dgloeckner/remote-token-dispenser/ARCHITECTURE.md

# Token Dispenser System Architecture

This document provides a detailed architectural overview of the remote token/coin dispenser system using diagrams and flow explanations.

**📘 For complete HTTP API specification, see [dispenser-protocol.md](dispenser-protocol.md)** - detailed endpoint documentation, request/response formats, error codes, and recovery scenarios.

## Table of Contents
1. [System Overview](#system-overview)
2. [Dispense-First, Pay-After Model](#dispense-first-pay-after-model)
3. [Component Architecture](#component-architecture)
   - [Hopper Signal Configuration](#hopper-signal-configuration)
4. [API Endpoints](#api-endpoints)
5. [Transaction Flows](#transaction-flows)
6. [State Machines](#state-machines)
7. [Hardware Error Decoding](#hardware-error-decoding)
   - [Error Signal Protocol](#error-signal-protocol)
   - [Azkoyen Error Codes](#azkoyen-error-codes)
   - [Error History Tracking](#error-history-tracking)
   - [Self-Healing Behavior](#self-healing-behavior)
8. [Error Recovery](#error-recovery)
9. [Maintenance & Monitoring](#maintenance--monitoring)
   - [System Monitor Role & Responsibilities](#system-monitor-role--responsibilities)
   - [Recovery Protocols](#recovery-protocols)
10. [Example Usage: Point-of-Sale Terminal](#example-usage-point-of-sale-terminal)

---

## System Overview

The token dispenser system is a distributed embedded system with three main components communicating over WiFi HTTP and GPIO.

```mermaid
graph TB
    subgraph "Client Device"
        UI[Client App<br/>User Interface]
        Monitor[System Monitor<br/>Health & Watchdog]
        DB[(Stable Storage<br/>Transactions)]
    end

    subgraph "ESP8266 (Wemos D1)"
        HTTP[HTTP Server<br/>Port 80]
        FSM[State Machine<br/>Transaction Control]
        Flash[(Flash Storage<br/>Crash Recovery)]
    end

    subgraph "Azkoyen Hopper U-II"
        Motor[Stepper Motor<br/>Token Dispensing]
        Sensor[Opto Sensor<br/>Token Counter]
    end

    UI -->|WiFi HTTP<br/>Dispense API| HTTP
    Monitor -->|WiFi HTTP<br/>Health Checks| HTTP
    UI <-->|Read/Write| DB
    Monitor -->|Read Only| DB

    HTTP <--> FSM
    FSM <-->|Read/Write| Flash
    FSM -->|GPIO Control| Motor
    Sensor -->|GPIO Interrupt| FSM

    style UI fill:#e1f5ff
    style Monitor fill:#e1f5ff
    style DB fill:#fff3e0
    style HTTP fill:#f3e5f5
    style FSM fill:#f3e5f5
    style Flash fill:#fff3e0
    style Motor fill:#e8f5e9
    style Sensor fill:#e8f5e9
```

### Key Design Principles

1. **Dispense First, Pay After** - Payment only created if tokens successfully dispensed.
2. **Idempotency by Transaction ID** - Every request carries a `tx_id`. Retries are safe.
3. **Single Resource Locking** - Only one transaction can be active at a time on ESP8266.
4. **Crash-Safe Persistence** - Both client and ESP8266 persist state to survive power loss.
5. **Local-First Architecture** - Client stable storage is the source of truth.

---

## Dispense-First, Pay-After Model

### Core Concept

This architecture follows a **dispense-first, pay-after** model: physical tokens are dispensed from the hardware **before** any payment transaction is created or account is debited. The payment only happens after successful dispensing is confirmed.

```mermaid
graph TB
    subgraph "Traditional POS Flow"
        T1[1. Charge User]
        T2[2. Attempt Dispense]
        T3{Success?}
        T4[3. Refund if Failed]
        T5[Complete]

        T1 --> T2
        T2 --> T3
        T3 -->|Failed| T4
        T3 -->|Success| T5
        T4 --> T5

        style T1 fill:#ffebee
        style T4 fill:#ffebee
    end

    subgraph "Dispense-First Flow"
        D1[1. Dispense Tokens]
        D2[2. Verify Count]
        D3{Success?}
        D4[3. Charge User<br/>only if OK]
        D5[Complete]
        D6[No Charge]

        D1 --> D2
        D2 --> D3
        D3 -->|Success| D4
        D3 -->|Failed| D6
        D4 --> D5
        D6 --> D5

        style D4 fill:#e8f5e9
        style D6 fill:#fff3e0
    end
```

### Why This Matters

**1. Customer Protection**
- Customer is **never charged for tokens they didn't receive**
- No need for refund processes when hardware fails
- No disputes about "I paid but got nothing"

**2. Simpler Failure Handling**
- Hardware jam? Don't create payment transaction
- Partial dispense (2/3 tokens)? Charge for 2
- Complete failure? No payment record needed

**3. Eliminates Reservation Complexity**
- No need for reserve→confirm two-phase protocol
- No cancellation flow required
- No timeout management for reservations
- No "money in limbo" state

**4. Clear Audit Trail**
```
Dispense Transaction:  {tx_id, user_id, quantity, dispensed, state}
Payment Transaction:   {payment_id, dispense_tx_id, amount, timestamp}
```

Payment transaction **only exists if** dispensing succeeded. The `dispense_tx_id` link provides perfect traceability.

### Guarantees

✅ **Customer never pays without receiving tokens**
✅ **Exact token count is always recorded** (even on partial dispense)
✅ **No refunds needed** (payment only created on success)
✅ **Simple retry logic** (if dispense fails, just try again)
✅ **Clean separation** between physical operation and financial transaction

### Trade-offs

This model works well when:
- Token dispensing is the **limiting resource** (single ESP8266, one dispenser)
- Account balances are **checked before** attempting dispense
- Failed dispenses are **acceptable** (customer just retries)

This model may need adjustment if:
- Multiple dispensers must coordinate
- Regulatory requirements mandate payment-before-service
- High-value transactions require strong guarantees before dispensing

For most token-operated services (saunas, laundromats, arcades), the dispense-first model is both simpler and more customer-friendly.

---

## Component Architecture

### Client Components

```mermaid
graph LR
    subgraph "Client Device"
        subgraph "Client Application"
            AuthDevice[Auth Device<br/>RFID/NFC/Card]
            UI[User Interface<br/>Display/Touch]
            PurchaseFlow[Purchase Flow]
            DispenserClient[Dispenser Client]
        end

        subgraph "Stable Storage"
            TxTable[Transactions Store]
            UserTable[Users Store]
        end

        subgraph "System Monitor"
            HealthPoller[Health Poller<br/>60s interval]
            Watchdog[App Watchdog<br/>Process Monitor]
            SysMonitor[System Monitor<br/>Disk/Temp/Memory]
            Reporter[External Reporter<br/>healthchecks.io]
        end
    end

    AuthDevice --> PurchaseFlow
    UI --> PurchaseFlow
    PurchaseFlow --> TxTable
    PurchaseFlow --> DispenserClient

    HealthPoller -.->|HTTP GET /health| DispenserClient
    Watchdog -->|restart app| PurchaseFlow
    SysMonitor -->|query count| TxTable

    HealthPoller --> Reporter
    Watchdog --> Reporter
    SysMonitor --> Reporter

    style AuthDevice fill:#e1f5ff
    style UI fill:#e1f5ff
    style TxTable fill:#fff3e0
    style Reporter fill:#ffebee
```

### ESP8266 Components

```mermaid
graph TB
    subgraph "ESP8266 (Wemos D1)"
        subgraph "HTTP Server"
            HealthEndpoint[GET /health]
            DispenseEndpoint[POST /dispense]
            StatusEndpoint[GET /dispense/:tx_id]
        end

        subgraph "Transaction Manager"
            ActiveTx[Active Transaction<br/>In-Memory State]
            History[Ring Buffer<br/>Last 8 Transactions]
            JamWatchdog[Jam Watchdog<br/>5s Timeout Detection]
        end

        subgraph "Hardware Controller"
            MotorCtrl[Motor Controller<br/>GPIO Output]
            TokenCounter[Token Counter<br/>GPIO Interrupt]
            ErrorDecoder[Error Decoder<br/>Azkoyen Error Signals]
        end

        FlashMgr[Flash Manager<br/>EEPROM/LittleFS]
    end

    HealthEndpoint --> ActiveTx
    DispenseEndpoint --> ActiveTx
    StatusEndpoint --> History

    ActiveTx --> FlashMgr
    ActiveTx --> MotorCtrl
    TokenCounter --> ActiveTx
    ErrorDecoder --> ActiveTx

    JamWatchdog -.->|Timeout error| ActiveTx

    style HealthEndpoint fill:#f3e5f5
    style DispenseEndpoint fill:#f3e5f5
    style StatusEndpoint fill:#f3e5f5
    style FlashMgr fill:#fff3e0
    style MotorCtrl fill:#e8f5e9
    style TokenCounter fill:#e8f5e9
```

### Hopper Signal Configuration

The Azkoyen Hopper U-II uses two separate signal types that must be configured correctly:

#### 1. Motor Control Signal (Pin 7)

**Mode:** NEGATIVE (active-LOW)
**Purpose:** Control when motor runs to dispense tokens
**Configured via:** DIP switch inside hopper (⚠️ CRITICAL - must be set to NEGATIVE mode)

```mermaid
sequenceDiagram
    participant ESP8266
    participant Optocoupler as PC817 Optocoupler
    participant Motor as Hopper Motor

    Note over ESP8266: GPIO HIGH (3.3V)
    ESP8266->>Optocoupler: LED ON (13.3mA)
    Optocoupler->>Motor: OUT LOW (~0.1V)
    Note over Motor: Motor ON (dispensing)

    Note over ESP8266: GPIO LOW (0V)
    ESP8266->>Optocoupler: LED OFF
    Optocoupler->>Motor: OUT HIGH (~6V)
    Note over Motor: Motor OFF (stopped)
```

**Why NEGATIVE Mode:**
- Matches our optocoupler circuit design (GPIO HIGH → Motor ON)
- POSITIVE mode would cause inverted behavior (motor runs when it shouldn't)
- See `docs/azkoyen-hopper-protocol.md` for complete protocol specification

#### 2. Coin Detection Signal (Pin 9)

**Mode:** PULSES
**Purpose:** Count dispensed tokens
**Configured via:** Hardware jumpers (set to PULSES mode)

```mermaid
sequenceDiagram
    participant Coin
    participant Sensor as Optical Sensor
    participant ESP8266

    Note over Sensor: HIGH (idle state)
    Coin->>Sensor: Token passes through
    Note over Sensor: LOW pulse<br/>EXACTLY 30-65ms
    Sensor->>ESP8266: Interrupt triggered
    ESP8266->>ESP8266: dispensed++
    Note over Sensor: HIGH (idle state)

    Note right of ESP8266: One discrete pulse<br/>per token<br/>Independent of<br/>token speed
```

**Why PULSES Mode for Coin Counting:**

**1. Trivial Interrupt Counting**
```cpp
volatile int dispensed = 0;

void IRAM_ATTR onCoinPulse() {
    dispensed++;  // One pulse = one token
}
```
No debouncing, no edge detection complexity, no state tracking.

**2. Unambiguous Counting**
- 1 pulse = 1 token. Always. Guaranteed by hopper hardware.
- No risk of double-counting during token passage
- No timing dependencies or token speed variations

**3. Hardware-Generated Clean Signals**
- 30-65ms pulse duration is fixed and validated by hopper
- No noise or bouncing issues
- No debounce logic required in firmware

**4. Minimal CPU Overhead**
- One interrupt per token
- Simple increment operation
- No continuous signal monitoring needed

**5. Predictable Timing**
- Known pulse duration for validation/debugging
- Easy to detect jam conditions (no pulse within 5s timeout)

#### Alternative Coin Detection Modes

**NEGATIVE Mode (Active-LOW Continuous):** Signal goes LOW when token enters sensor, stays LOW while token is present, returns HIGH when token exits. Duration varies by token speed.

**POSITIVE Mode (Active-HIGH Continuous):** Signal goes HIGH when token enters sensor, stays HIGH while token is present, returns LOW when token exits. Duration varies by token speed.

**Why we don't use continuous modes for counting:**
- Require debouncing logic
- Token speed affects signal timing
- Risk of double-counting if token moves slowly
- More complex interrupt handling

These modes exist for:
- PLC integration preferring level-based signals
- Systems requiring continuous feedback during token passage
- Legacy systems with specific signal requirements

**Configuration Summary:**
- **Motor Control (Pin 7):** DIP switch set to **NEGATIVE mode** (⚠️ CRITICAL)
- **Coin Counting (Pin 9):** Jumpers set to **PULSES mode**
- See `docs/azkoyen-hopper-protocol.md` for detailed specifications

---

## API Endpoints

> **📘 Complete API Reference:** For full endpoint specifications, request/response formats, error codes, and code examples, see **[dispenser-protocol.md](dispenser-protocol.md)**.

### Authentication

**Dispense operations** (`POST /dispense`, `GET /dispense/{tx_id}`) require API key authentication:

```http
X-API-Key: your-secret-key-here
```

**Unauthorized Response (401):**
```json
{
  "error": "unauthorized"
}
```

**Health endpoint** (`GET /health`) does NOT require authentication - it's used for monitoring and diagnostics.

---

### GET /health

Returns ESP8266 health status and accumulated error metrics for monitoring.

**No authentication required** - open for monitoring systems.

> **📘 Complete API Reference:** For full response format including all fields (`wifi`, `gpio`, `error`, `error_history`), see **[dispenser-protocol.md](dispenser-protocol.md#get-health)**.

**Request:**
```http
GET /health HTTP/1.1
Host: 192.168.x.20
```

**Response Overview:**
```json
{
  "status": "ok",
  "uptime": 84230,
  "firmware": "<version>",
  "dispenser": "idle",
  "wifi": { ... },
  "gpio": { ... },
  "metrics": {
    "total_dispenses": 1247,
    "successful": 1189,
    "jams": 3,
    "partial": 2,
    "failures": 53
  },
  "error": {
    "active": false
  },
  "error_history": [ ... ]
}
```

**Key Response Fields:**
- `dispenser`: Current state (`"idle"`, `"dispensing"`, `"error"`)
- `metrics`: Cumulative statistics since boot
- `error`: Active hardware error information (if any)
- `error_history`: Last 5 error events with timestamps
- `gpio`: Real-time GPIO pin states for diagnostics
- `wifi`: Network connection information

**Purpose:**
- System Monitor polls this every 60s
- Tracks reliability over time (success rate = successful / total_dispenses)
- Detects increasing jam rates requiring maintenance
- Reports comprehensive health to external monitoring (healthchecks.io)
- Provides hardware error diagnostics via error decoding

**Example Derived Metrics:**
- **Success rate**: `successful / total_dispenses`
- **Jam rate**: `jams / total_dispenses`
- **Recent reliability**: Track deltas between polls to detect degradation
- **Active errors**: Check `error.active` for current faults

**Status Levels:**
- `"ok"`: Operating normally, no active errors
- `"degraded"`: Hopper low warning, or elevated error rates
- `"error"`: Active jam/fault, dispenser unavailable

---

## Transaction Flows

### Primary Flow: Dispense Transaction

**Design principle: Dispense first, pay after.** The payment transaction is only created if tokens are successfully dispensed.

```mermaid
sequenceDiagram
    participant User
    participant Client as Client App
    participant DB as Stable Storage
    participant ESP8266
    participant Hopper as Azkoyen Hopper

    User->>Client: Authenticate<br/>(RFID/card/etc)
    Client->>Client: Verify user
    User->>Client: Select quantity (3 tokens)

    Note over Client: Generate tx_id: "a3f8c012"
    Client->>DB: WRITE dispense transaction<br/>(tx_id, user_id, qty=3, state=pending)
    DB-->>Client: OK

    Client->>ESP8266: POST /dispense<br/>{tx_id: "a3f8c012", quantity: 3}

    ESP8266->>ESP8266: Check if idle
    ESP8266->>ESP8266: Set state=dispensing
    ESP8266->>ESP8266: Persist to flash
    ESP8266->>Hopper: Start motor (GPIO HIGH)
    ESP8266-->>Client: 200 {state: "dispensing", dispensed: 0}

    Client->>DB: UPDATE state=dispensing

    Note over Client,ESP8266: Polling Loop
    loop Every 250ms
        Client->>ESP8266: GET /dispense/a3f8c012
        Hopper-->>ESP8266: Token drop detected (interrupt)
        ESP8266->>ESP8266: Increment dispensed counter
        ESP8266-->>Client: 200 {state: "dispensing", dispensed: 1/2/3}
        Client->>User: Update progress: ●●○
    end

    ESP8266->>ESP8266: dispensed == quantity (3)
    ESP8266->>Hopper: Stop motor (GPIO LOW)
    ESP8266->>ESP8266: Set state=done
    ESP8266->>ESP8266: Persist to flash

    Client->>ESP8266: GET /dispense/a3f8c012
    ESP8266-->>Client: 200 {state: "done", dispensed: 3}

    Client->>DB: UPDATE state=complete, dispensed=3

    Note over Client: Dispense successful!<br/>Now create payment transaction
    Client->>DB: WRITE payment transaction<br/>(dispense_tx_id, user_id, amount, deduct_from_account)

    Client->>User: Success! Take 3 tokens<br/>Account charged
```

### Conflict Handling

When a second client tries to dispense while the ESP8266 is already busy.

```mermaid
sequenceDiagram
    participant User1
    participant Client1 as Client (Terminal 1)
    participant ESP8266
    participant Client2 as Client (Terminal 2)
    participant User2

    Note over ESP8266: Active: tx_id "aaa"<br/>State: dispensing

    User1->>Client1: Dispensing in progress...

    User2->>Client2: Try to start new transaction
    Client2->>ESP8266: POST /dispense<br/>{tx_id: "bbb", quantity: 2}

    ESP8266->>ESP8266: Check if idle
    Note over ESP8266: NOT idle!<br/>tx "aaa" active

    ESP8266-->>Client2: 409 Conflict<br/>{error: "busy", active_tx_id: "aaa"}

    Client2->>User2: ⚠️ Dispenser busy<br/>Please wait...

    Note over Client2: Retry after delay
    Client2->>Client2: Wait 2s

    Note over ESP8266: tx "aaa" completes
    ESP8266->>ESP8266: State: idle

    Client2->>ESP8266: POST /dispense (retry)<br/>{tx_id: "bbb", quantity: 2}
    ESP8266-->>Client2: 200 {state: "dispensing", dispensed: 0}

    Client2->>User2: Dispensing...
```

---

## State Machines

### ESP8266 Transaction State Machine

```mermaid
stateDiagram-v2
    [*] --> idle

    idle --> dispensing: POST /dispense<br/>{tx_id, quantity}

    dispensing --> done: all tokens dispensed
    dispensing --> error: jam detected<br/>OR timeout

    done --> idle: cleanup (5min)
    error --> idle: manual reset

    note right of idle
        Dispenser available
        No active tx_id
        Returns 409 if busy
    end note

    note right of dispensing
        Motor running
        Counting tokens
        tx_id persisted to flash
    end note

    note right of done
        Success
        tx_id kept in history
        for idempotency
    end note

    note right of error
        Partial dispense
        Exact count recorded
        Manual intervention needed
    end note
```

### Client Transaction Lifecycle

```mermaid
stateDiagram-v2
    [*] --> pending

    pending --> dispensing: ESP8266 dispense started
    pending --> failed: ESP8266 busy/error

    dispensing --> complete: All tokens dispensed
    dispensing --> partial: Jam/error with count < quantity
    dispensing --> failed: Hardware error with count = 0

    complete --> paid: Payment transaction created
    partial --> paid: Partial payment/refund processed

    paid --> [*]
    failed --> [*]

    note right of pending
        Dispense transaction created
        Not yet sent to ESP8266
    end note

    note right of dispensing
        Active polling
        Progress tracking
        Motor running on ESP8266
    end note

    note right of complete
        dispensed == quantity
        Ready for payment
    end note

    note right of partial
        dispensed < quantity
        Charge for actual amount
        or issue refund
    end note

    note right of paid
        Payment transaction created
        Account debited
        Final state
    end note
```

---

## Hardware Error Decoding

The system includes real-time decoding of Azkoyen Hopper error signals transmitted via Pin 8 (error signal). The hopper uses pulse-encoded error codes to communicate hardware faults.

### Error Signal Protocol

The Azkoyen Hopper reports errors using a pulse-encoded protocol:

```mermaid
sequenceDiagram
    participant Hopper
    participant ESP8266 as ESP8266 Error Decoder

    Note over Hopper: Error condition detected<br/>(e.g., coin stuck)

    Hopper->>ESP8266: Start pulse (100ms LOW)
    Note over ESP8266: Decoder enters START_PULSE state

    Hopper->>ESP8266: Code pulse 1 (10ms LOW)
    Note over ESP8266: pulseCount = 1

    Hopper->>ESP8266: Code pulse 2 (10ms LOW)
    Note over ESP8266: pulseCount = 2

    Hopper->>ESP8266: Code pulse 3 (10ms LOW)
    Note over ESP8266: pulseCount = 3

    Note over Hopper: End of sequence (200ms timeout)

    Note over ESP8266: Decode: 3 pulses = JAM_PERMANENT<br/>Record in error history
```

**Pulse Timing:**
- **Start pulse:** 100ms ±10% (90-110ms) LOW signal
- **Code pulses:** 10ms ±20% (8-12ms) LOW signals
- **Sequence timeout:** 200ms after last pulse
- **Error code:** Number of code pulses (1-7)

### Azkoyen Error Codes

| Code | Type | Description | Typical Cause | Resolution |
|---|---|---|---|---|
| 1 | `COIN_STUCK` | Token stuck in exit sensor (>65ms) | Token jammed at exit path | Clear exit, power cycle |
| 2 | `SENSOR_OFF` | Exit sensor stuck OFF | Sensor blocked or misaligned | Clean/adjust sensor |
| 3 | `JAM_PERMANENT` | Permanent jam detected | Hopper mechanism jammed | Clear jam, power cycle |
| 4 | `MAX_SPAN` | Multiple spans exceeded max time | Motor running too long | Check hopper load |
| 5 | `MOTOR_FAULT` | Motor doesn't start | Motor or driver failure | Check 12V power |
| 6 | `SENSOR_FAULT` | Exit sensor disconnected/faulty | Sensor wiring issue | Check connections |
| 7 | `POWER_FAULT` | Power supply out of range | 12V supply voltage abnormal | Check power supply |

### Error History Tracking

The ESP8266 maintains a circular buffer of the last 5 error events:

```cpp
struct ErrorRecord {
  ErrorCode code;        // 1-7 (error type)
  uint32_t timestamp;    // Uptime when detected
  bool cleared;          // Whether error was resolved
};
```

**Error Lifecycle:**

```mermaid
stateDiagram-v2
    [*] --> Detected: Error signal decoded

    Detected --> Active: Recorded in history<br/>cleared=false

    Active --> Cleared: Successful dispense<br/>OR power cycle

    Cleared --> [*]: Updated in history<br/>cleared=true

    note right of Active
        Visible in GET /health
        error.active = true
        Prevents new dispenses
    end note

    note right of Cleared
        Kept in error_history
        error.active = false
        System operational
    end note
```

### Self-Healing Behavior

**Transient errors** (temporary hardware issues) can self-heal without manual intervention:

**Mechanism:**
1. Hopper reports error (e.g., `COIN_STUCK`)
2. Error recorded in history with `cleared: false`
3. Customer initiates new dispense transaction
4. If dispense completes successfully:
   - ESP8266 automatically clears active error
   - Error marked as `cleared: true` in history
   - Dispenser continues normal operation

**Benefits:**
- Reduces maintenance interventions for transient issues
- System automatically recovers from temporary faults
- Complete audit trail maintained in error history
- No downtime for self-clearing errors

**Example Flow:**

```mermaid
sequenceDiagram
    participant Hopper
    participant ESP8266
    participant Client

    Hopper->>ESP8266: Error signal (code 1: COIN_STUCK)
    ESP8266->>ESP8266: Record error<br/>active=true, cleared=false

    Client->>ESP8266: GET /health
    ESP8266-->>Client: {error: {active: true, code: 1}}

    Note over Client: Customer attempts dispense

    Client->>ESP8266: POST /dispense {tx_id, quantity: 3}
    ESP8266->>Hopper: Start motor
    Hopper->>ESP8266: 3 token pulses
    ESP8266->>ESP8266: Dispense complete!<br/>Clear active error

    Note over ESP8266: error.active = false<br/>error.cleared = true

    Client->>ESP8266: GET /health
    ESP8266-->>Client: {error: {active: false}, error_history: [{code: 1, cleared: true}]}

    Note over Client,ESP8266: System self-healed
```

**Non-Self-Healing Errors:**

Some errors require manual intervention:
- **Timeout jams** (detected via watchdog, not hardware signal)
- **Persistent hardware faults** that don't clear after successful dispense
- **Critical errors** that prevent motor operation

These require power cycle to reset.

### Error Monitoring

The `/health` endpoint provides comprehensive error diagnostics:

```json
{
  "error": {
    "active": true,
    "code": 3,
    "type": "JAM_PERMANENT",
    "timestamp": 82150,
    "description": "Permanent jam detected"
  },
  "error_history": [
    {
      "code": 3,
      "type": "JAM_PERMANENT",
      "timestamp": 82150,
      "cleared": false
    },
    {
      "code": 1,
      "type": "COIN_STUCK",
      "timestamp": 75400,
      "cleared": true
    }
  ]
}
```

**Use Cases:**
- **Diagnostics:** Identify specific hardware issues via error codes
- **Trend analysis:** Track error frequency and types over time
- **Maintenance planning:** High error rates indicate need for service
- **Root cause analysis:** Error history provides failure patterns

---

## Error Recovery

### Scenario 1: ESP8266 Crashes Mid-Dispense

```mermaid
sequenceDiagram
    participant Client
    participant ESP8266
    participant Flash as ESP8266 Flash
    participant Hopper

    Note over ESP8266: Dispensing tx "abc"<br/>quantity: 3<br/>dispensed: 2

    ESP8266->>Flash: Persist {tx: "abc", qty: 3, dispensed: 2}
    Flash-->>ESP8266: OK

    Note over ESP8266: 💥 POWER LOSS

    Note over ESP8266: ...reboot...

    ESP8266->>ESP8266: Boot sequence
    ESP8266->>Flash: Read persisted state
    Flash-->>ESP8266: {tx: "abc", qty: 3, dispensed: 2}

    ESP8266->>ESP8266: Recover to error state<br/>(incomplete transaction)
    Note over ESP8266: State: error<br/>tx "abc", dispensed=2

    Client->>ESP8266: GET /dispense/abc<br/>(periodic poll after timeout)

    ESP8266-->>Client: 200 {state: "error", error: "reboot",<br/>quantity: 3, dispensed: 2}

    Client->>Client: Record partial dispense
    Note over Client: Storage: state=partial<br/>dispensed=2

    Client->>Client: Show error to user
    Note over Client: "Partial dispense: 2/3 tokens.<br/>Contact staff."
```

### Scenario 2: Client Crashes Mid-Transaction

```mermaid
sequenceDiagram
    participant Client
    participant DB as Stable Storage
    participant ESP8266

    Note over Client: Dispensing tx "xyz"<br/>polling ESP8266...

    Note over Client: 💥 POWER LOSS

    Note over Client: ...reboot...
    Note over ESP8266: Still dispensing<br/>or completed

    Client->>Client: Boot sequence
    Client->>DB: READ transactions<br/>WHERE state IN ('pending', 'dispensing')

    DB-->>Client: [{tx_id: "xyz", state: "dispensing", qty: 3}]

    Client->>ESP8266: GET /dispense/xyz

    alt Transaction completed during outage
        ESP8266-->>Client: 200 {state: "done", dispensed: 3}
        Client->>DB: UPDATE state=complete, dispensed=3
        Note over Client: Recovery successful
    else Transaction still in progress
        ESP8266-->>Client: 200 {state: "dispensing", dispensed: 2}
        Client->>Client: Resume polling
        Note over Client: Continue normal flow
    else Transaction errored
        ESP8266-->>Client: 200 {state: "error", dispensed: 2}
        Client->>DB: UPDATE state=partial, dispensed=2
        Note over Client: Manual intervention
    else Transaction timed out
        ESP8266-->>Client: 404 Not Found
        Client->>DB: UPDATE state=expired
        Note over Client: Refund/retry logic
    end
```

### Scenario 3: Network Timeout During Dispense Request

```mermaid
sequenceDiagram
    participant Client
    participant Network as WiFi Network
    participant ESP8266

    Note over ESP8266: State: idle

    Client->>Network: POST /dispense<br/>{tx_id: "def", quantity: 3}

    Note over Network: 📡 Packet lost

    Note over Client: Timeout (3s)
    Note over ESP8266: Never received request!<br/>Still idle

    Client->>Client: Retry logic (attempt 2)
    Client->>ESP8266: POST /dispense<br/>{tx_id: "def", quantity: 3}<br/>[SAME tx_id]

    ESP8266->>ESP8266: Check tx_id "def"
    Note over ESP8266: Not found in history<br/>New transaction

    ESP8266->>ESP8266: Start dispensing
    ESP8266-->>Client: 200 {state: "dispensing", dispensed: 0}

    Note over Client,ESP8266: Safe retry - dispense starts on first successful delivery
```

### Scenario 4: Hopper Jam Detection

```mermaid
sequenceDiagram
    participant Client
    participant ESP8266 as ESP8266 Firmware
    participant Hopper

    Note over ESP8266: Dispensing tx "ghi"<br/>quantity: 4<br/>dispensed: 2

    ESP8266->>Hopper: Motor running (GPIO HIGH)
    ESP8266->>ESP8266: Start watchdog timer<br/>(5s per-token timeout)

    Note over Hopper: 🔧 Jam! No token drops

    Note over ESP8266: Wait 5s...<br/>No pulse received!<br/>Watchdog timeout triggered

    ESP8266->>Hopper: Stop motor (GPIO LOW)
    ESP8266->>ESP8266: Set state=error<br/>error="jam"<br/>dispensed=2
    ESP8266->>ESP8266: Persist to flash

    Client->>ESP8266: GET /dispense/ghi<br/>(polling)

    ESP8266-->>Client: 200 {state: "error", error: "jam",<br/>quantity: 4, dispensed: 2}

    Client->>Client: Update storage: state=partial, dispensed=2
    Client->>Client: Show error UI

    Note over Client: "Hardware error: 2/4 tokens dispensed.<br/>Contact staff to clear jam."
```

---

## Example Usage: Point-of-Sale Terminal

### Example Physical Layout

```mermaid
graph TB
    subgraph "Counter Top"
        Terminal[POS Terminal<br/>Client Device<br/>Display + Auth Device]
    end

    subgraph "Behind/Below Counter"
        Dispenser[Enclosure<br/>ESP8266 + Azkoyen Hopper]
    end

    subgraph "Network Infrastructure"
        WiFi[WiFi Router<br/>Local Network<br/>192.168.x.x]
        Internet[Internet<br/>External Monitoring]
    end

    Terminal -->|WiFi| WiFi
    Dispenser -->|WiFi| WiFi
    Terminal -->|Optional| Internet

    style Terminal fill:#e1f5ff
    style Dispenser fill:#f3e5f5
    style WiFi fill:#fff3e0
    style Internet fill:#ffebee
```

**Example Scenario: Sauna Token Dispenser**

A customer approaches the POS terminal at a sauna facility:

1. **Authentication**: Customer taps RFID card on terminal
2. **Selection**: Display shows available packages (1, 3, or 5 sauna tokens)
3. **Transaction Request**: Customer selects 3 tokens
4. **Balance Check**: System verifies customer has sufficient balance
5. **tx_id Generation**: Client creates unique transaction ID (e.g., "a3f8c012")
6. **Stable Storage**: Dispense transaction recorded locally (pending state)
7. **Dispense Command**: Client sends POST /dispense to ESP8266 over WiFi
8. **Dispensing**: ESP8266 begins dispensing, motor runs
9. **Progress**: Display shows progress as tokens drop (●●○)
10. **Completion**: 3 tokens dispensed successfully, dispense transaction marked complete
11. **Payment**: Payment transaction created, customer account debited for 3 tokens
12. **Receipt**: Customer takes tokens and optional receipt

### Network Architecture

```mermaid
graph LR
    subgraph "Local Network (192.168.x.x)"
        Client[Client Device<br/>192.168.x.10]
        ESP[ESP8266<br/>192.168.x.20<br/>Static IP]
        Router[WiFi Router<br/>192.168.x.1]
    end

    subgraph "Internet"
        Monitor[External Monitoring<br/>healthchecks.io]
    end

    Client -->|HTTP Client| ESP
    Client -->|Optional HTTPS| Monitor
    ESP -.->|Optional OTA| Router
    Router --> Internet

    style Client fill:#e1f5ff
    style ESP fill:#f3e5f5
    style Router fill:#fff3e0
    style Monitor fill:#ffebee
```

### Data Persistence

```mermaid
graph TB
    subgraph "Client Storage"
        StableStorage[(Stable Storage<br/>transactions.db/json/etc)]
        Logs[Log Files]
        Config[Configuration]
    end

    subgraph "ESP8266 Storage"
        Flash[(Flash Storage<br/>EEPROM/LittleFS)]
        FlashData[Active Transaction<br/>tx_id, qty, dispensed]
    end

    StableStorage -->|Backup| Backup[Optional Backup<br/>External/Cloud Storage]
    Flash -->|Recoverable| FlashData

    style StableStorage fill:#fff3e0
    style Flash fill:#fff3e0
    style Backup fill:#e8f5e9
```

---

## API Communication Patterns

### Health Monitoring Flow

```mermaid
sequenceDiagram
    participant Monitor as System Monitor
    participant ESP8266
    participant External as External Reporting

    Note over Monitor: Every 60 seconds

    loop Health Check Cycle
        Monitor->>ESP8266: GET /health
        ESP8266-->>Monitor: 200 {<br/>status: "ok",<br/>dispenser: "idle",<br/>metrics: {<br/>  total_dispenses: 1247,<br/>  successful: 1189,<br/>  jams: 3,<br/>  partial: 2<br/>},<br/>error: { active: false },<br/>...<br/>}

        Monitor->>Monitor: Check system metrics<br/>- Disk space<br/>- CPU temp<br/>- Memory<br/>- Incomplete transactions<br/>- Analyze error rates<br/>- Check for active errors

        alt All OK
            Monitor->>External: POST /{uuid}<br/>Body: "esp32:ok hopper:ok disk:2GB temp:45C"
        else Any Warning/Critical
            Monitor->>External: POST /{uuid}/fail<br/>Body: "esp32:unreachable hopper:low disk:300MB"
        end

        Monitor->>Monitor: Sleep 60s
    end
```

### Idempotent Request Handling

```mermaid
sequenceDiagram
    participant Client
    participant ESP8266
    participant History as Ring Buffer

    Client->>ESP8266: POST /dispense<br/>{tx_id: "aaa", quantity: 3}
    ESP8266->>ESP8266: New tx_id, start dispensing
    ESP8266->>History: Store tx "aaa"
    ESP8266-->>Client: 200 {state: "dispensing", dispensed: 0}

    Note over Client: Network glitch,<br/>no response received

    Client->>ESP8266: POST /dispense (RETRY)<br/>{tx_id: "aaa", quantity: 3}
    ESP8266->>History: Check tx "aaa"
    Note over ESP8266: Found! Return current state
    ESP8266-->>Client: 200 {state: "dispensing", dispensed: 1}<br/>[Idempotent - no duplicate dispense]

    Note over Client: Poll for status

    Client->>ESP8266: GET /dispense/aaa
    ESP8266-->>Client: 200 {state: "dispensing", dispensed: 2}

    Client->>ESP8266: GET /dispense/aaa
    ESP8266-->>Client: 200 {state: "done", dispensed: 3}

    Note over ESP8266,Client: Safe to retry any request<br/>with same tx_id
```

---

## Performance Characteristics

### Timing Budget

```mermaid
gantt
    title Typical Dispense Transaction Timeline (3 tokens)
    dateFormat X
    axisFormat %Ls

    section Client
    Generate tx_id & write to storage    :0, 50ms
    HTTP dispense request        :50ms, 100ms

    section ESP8266
    Start dispensing             :50ms, 100ms
    Token 1 dispense            :150ms, 2000ms
    Token 2 dispense            :2150ms, 2000ms
    Token 3 dispense            :4150ms, 2000ms

    section Client
    Poll loop (3 tokens)         :150ms, 6000ms
    Storage update complete      :6150ms, 50ms
    Create payment transaction   :6200ms, 50ms
```

### System Capacity

| Metric | Value | Notes |
|---|---|---|
| **Dispense rate** | 1 token per 2-3 seconds | Limited by Azkoyen motor |
| **Max transaction size** | 20 tokens | Configurable limit |
| **Concurrent transactions** | 1 | Single-resource lock on ESP8266 |
| **Transaction history** | Last 8 tx_ids | Ring buffer for idempotency |
| **HTTP timeout** | 3 seconds | With 3 retries |
| **Poll interval** | 250ms during dispense | Real-time progress updates |
| **WiFi range** | 10-20 meters | Typical indoor range |

---

## Security Considerations

```mermaid
graph TB
    subgraph "Security Layers"
        A[Physical Security<br/>Locked enclosure]
        B[Network Security<br/>Local WiFi only]
        C[Application Security<br/>Transaction validation]
        D[Data Security<br/>Local storage only]
    end

    A --> B
    B --> C
    C --> D

    style A fill:#ffebee
    style B fill:#fff3e0
    style C fill:#e8f5e9
    style D fill:#e1f5ff
```

### Threat Model

| Threat | Mitigation |
|---|---|
| **Unauthorized dispense** | Transaction must be in client stable storage before ESP8266 accepts request |
| **Replay attacks** | tx_id stored in ring buffer, duplicates return cached state |
| **Network sniffing** | Local WiFi only, no sensitive data in protocol |
| **Physical tampering** | Locked enclosure, audit trail in stable storage |
| **Double-spend** | Single-resource lock, tx_id deduplication |
| **Power loss fraud** | Flash persistence records exact dispensed count |

---

## Maintenance & Monitoring

### Operational States

```mermaid
stateDiagram-v2
    [*] --> Operational

    Operational --> Degraded: Hopper low warning
    Operational --> Offline: healthchecks.io timeout
    Operational --> Error: Hopper jam

    Degraded --> Operational: Hopper refilled
    Degraded --> Error: Hopper empty

    Error --> Maintenance: Manual intervention
    Offline --> Operational: System restored

    Maintenance --> Operational: Issue resolved

    note right of Operational
        ✅ All systems OK
        ✅ ESP8266 responding
        ✅ Hopper has tokens
    end note

    note right of Degraded
        ⚠️ Low token warning
        ⚠️ Disk space low
        System still functional
    end note

    note right of Error
        ❌ Hopper jam
        ❌ Hopper empty
        ❌ Hardware fault
        Cannot dispense
    end note

    note right of Offline
        ❌ No healthcheck pings
        ❌ ESP8266 unreachable
        ❌ Client crashed
    end note
```

### Monitoring Dashboard Example

The system monitor can report comprehensive health status every 60 seconds:

```
Status: OK / DEGRADED / CRITICAL
━━━━━━━━━━━━━━━━━━━━━━━━━━━━━━━━━
ESP8266:          OK (uptime: 23h 27m)
Hopper:         OK (tokens available)
Dispenser:      idle
Client App:     running

Reliability Metrics:
Total Dispenses:     1,247
Success Rate:        95.4% (1,189 successful)
Jams:                3 (0.24%)
Partial Dispenses:   2 (0.16%)
Failures:            53 (4.25%)
Last Error:          2025-02-07 14:23 (jam)

System Health:
Disk Free:           2.1 GB
CPU Temp:            47°C
Incomplete Txns:     0 (pending/dispensing)

Last Updated:        2025-02-08 14:23:45 UTC
```

---

### System Monitor Role & Responsibilities

The System Monitor is a dedicated component (daemon/service) running on the client device with the following responsibilities:

#### 1. ESP8266 Health Monitoring

**Polling Interval:** Every 60 seconds

**Actions:**
```
GET /health → ESP8266
├─ Parse response metrics
├─ Calculate success rates
├─ Detect error rate thresholds
└─ Report to external monitoring
```

**Calculations from Health Data:**

```python
# System Monitor calculates from GET /health response:

health = {
    "metrics": {
        "total_dispenses": 1247,
        "successful": 1189,
        "jams": 3,
        "partial": 2,
        "failures": 53
    }
}

# Success Rate = (successful dispenses / total attempts) * 100
success_rate = (health["metrics"]["successful"] /
                health["metrics"]["total_dispenses"]) * 100
# Result: (1189 / 1247) * 100 = 95.35%

# Jam Rate = (jam errors / total attempts) * 100
jam_rate = (health["metrics"]["jams"] /
            health["metrics"]["total_dispenses"]) * 100
# Result: (3 / 1247) * 100 = 0.24%
```

**Thresholds & Alerts:**

**Critical (Immediate Attention):**
- `dispenser == "error"` → 🚨 CRITICAL "Dispenser jammed! Manual intervention required"
- New jam detected (`jams` increased) → 🚨 CRITICAL "Jam occurred! Clear hopper"
- No response for 3 consecutive polls → 🚨 CRITICAL "ESP8266 offline"

**Warning (Maintenance Needed):**
- `jam_rate > 5%` → ⚠️ WARNING "Frequent jams - schedule maintenance"
- `success_rate < 90%` → ⚠️ WARNING "Hardware degradation - inspect hopper"

**Example Alert Logic:**

```python
def check_health_thresholds(health_data, previous_health_data=None):
    """Check health and fire appropriate alerts"""

    # CRITICAL: Check if dispenser is currently in error state
    if health_data["dispenser"] == "error":
        critical_alert("🚨 Dispenser jammed! Manual intervention required NOW")
        # Dispenser cannot operate, customers waiting
        return  # Stop here, other checks not relevant

    metrics = health_data["metrics"]

    if metrics["total_dispenses"] == 0:
        return  # No data yet, skip checks

    # CRITICAL: Check if new jam occurred since last poll
    if previous_health_data:
        prev_jams = previous_health_data["metrics"]["jams"]
        curr_jams = metrics["jams"]

        if curr_jams > prev_jams:
            critical_alert(f"🚨 NEW JAM DETECTED! Jams: {prev_jams} → {curr_jams}")
            # Requires immediate clearing

    # WARNING: Calculate rates for maintenance planning
    success_rate = (metrics["successful"] / metrics["total_dispenses"]) * 100
    jam_rate = (metrics["jams"] / metrics["total_dispenses"]) * 100

    if success_rate < 90.0:
        warning_alert(f"⚠️ Hardware degradation: Success rate {success_rate:.1f}% "
                     f"(threshold: 90%) - Inspect hopper")

    if jam_rate > 5.0:
        warning_alert(f"⚠️ Frequent jams: Jam rate {jam_rate:.1f}% (threshold: 5%) "
                     f"- Schedule maintenance")

    # Additional monitoring
    partial_rate = (metrics["partial"] / metrics["total_dispenses"]) * 100
    if partial_rate > 2.0:
        warning_alert(f"⚠️ High partial dispense rate: {partial_rate:.1f}% "
                     f"(threshold: 2%)")
```

**Real-World Example:**

| Scenario | State | Total | Successful | Jams | Success Rate | Jam Rate | Alert Level | Action |
|---|---|---|---|---|---|---|---|---|
| **Healthy** | idle | 1,247 | 1,189 | 3 | 95.4% | 0.24% | ✅ OK | None |
| **Active Jam** | error | 1,247 | 1,189 | 4 | 95.3% | 0.32% | 🚨 CRITICAL | Clear jam NOW |
| **Degraded** | idle | 1,000 | 850 | 45 | 85.0% | 4.5% | ⚠️ WARNING | Inspect soon |
| **Needs Maintenance** | idle | 500 | 420 | 30 | 84.0% | 6.0% | ⚠️ WARNING | Schedule maint |
| **Worn Out** | idle | 200 | 140 | 15 | 70.0% | 7.5% | ⚠️ WARNING | Replace parts |

**Key Distinction:**
- **dispenser: "error"** = Right now problem (CRITICAL, stop everything)
- **High jam rate** = Historical trend (WARNING, schedule maintenance)

**Trending Analysis:**

System Monitor can also track rate of change:

```python
def analyze_trends(current_health, previous_health):
    """Compare current vs previous poll (60s ago)"""

    curr_metrics = current_health["metrics"]
    prev_metrics = previous_health["metrics"]

    # Calculate new dispenses in last 60 seconds
    new_dispenses = curr_metrics["total_dispenses"] - prev_metrics["total_dispenses"]
    new_jams = curr_metrics["jams"] - prev_metrics["jams"]

    if new_dispenses > 0:
        recent_jam_rate = (new_jams / new_dispenses) * 100

        # Alert if recent jam rate is high (even if overall is OK)
        if recent_jam_rate > 10.0:
            alert(f"Recent jam rate spike: {recent_jam_rate:.1f}% in last minute")
```

This allows **early detection** of degradation before overall metrics cross thresholds!

#### 2. Client Application Watchdog

**Purpose:** Detect and recover from client app crashes

**Mechanism:**
```
Every 30 seconds:
├─ Check if client app process is running
├─ If not running:
│   ├─ Log crash event
│   ├─ Trigger recovery protocol
│   └─ Restart client app
└─ If running but unresponsive:
    ├─ Check incomplete transactions >5 minutes old
    ├─ If found: Force restart client app
    └─ Trigger transaction reconciliation
```

#### 3. System Health Monitoring

**Metrics Tracked:**
- Disk space (alert if <500MB free)
- CPU temperature (alert if >80°C)
- Memory usage
- Incomplete transactions count

#### 4. External Reporting

**Target:** healthchecks.io (or similar)

**Payload:**
```
POST /{uuid}
Body: "esp32:ok success_rate:95.4% jams:3 disk:2.1GB temp:47C incomplete:0"

OR on failure:

POST /{uuid}/fail
Body: "esp32:unreachable incomplete:3 last_seen:5m_ago"
```

---

### Recovery Protocols

#### Protocol 1: Client Crash Recovery

**Trigger:** Client app process not found, or detected incomplete transactions >5 minutes old

**Recovery Steps:**

```mermaid
sequenceDiagram
    participant Monitor as System Monitor
    participant Client as Client App
    participant DB as Stable Storage
    participant ESP8266

    Note over Monitor: Detect crash:<br/>App not running OR<br/>old incomplete txns

    Monitor->>Client: Restart client app

    Note over Client: Boot sequence begins

    Client->>DB: Query incomplete transactions
    DB-->>Client: [{tx_id: "xyz", state: "dispensing", qty: 3}]

    Note over Client: Found incomplete transaction!<br/>Need to reconcile

    Client->>ESP8266: GET /dispense/xyz

    alt Transaction completed during crash
        ESP8266-->>Client: 200 {state: "done", dispensed: 3}
        Client->>DB: UPDATE state=complete, dispensed=3
        Client->>DB: CREATE payment transaction
        Note over Client: Recovery successful!
    else Transaction partially completed
        ESP8266-->>Client: 200 {state: "error", dispensed: 2}
        Client->>DB: UPDATE state=partial, dispensed=2
        Client->>DB: CREATE partial payment OR refund
        Note over Client: User charged for 2 tokens only
    else Transaction failed/timed out
        ESP8266-->>Client: 404 Not Found
        Client->>DB: UPDATE state=failed
        Note over Client: No payment, user can retry
    else Transaction still in progress (unlikely)
        ESP8266-->>Client: 200 {state: "dispensing", dispensed: 1}
        Client->>Client: Resume polling
        Note over Client: Continue normal flow
    end

    Monitor->>Monitor: Verify recovery:<br/>Check incomplete count again
```

**Key Principles:**
- ✅ ESP8266 is source of truth for dispense status
- ✅ Client reconciles local DB with ESP8266 reality
- ✅ Payment only created after confirming actual dispensed count
- ✅ No double-charging (payment tied to dispense outcome)

#### Protocol 2: ESP8266 Crash Recovery

**Trigger:** ESP8266 reboots (power loss, firmware crash)

**ESP8266 Actions on Boot:**

```mermaid
sequenceDiagram
    participant ESP8266
    participant Flash as ESP8266 Flash
    participant Client

    Note over ESP8266: 💥 Reboot (power loss)

    ESP8266->>ESP8266: Boot sequence

    ESP8266->>Flash: Read persisted transaction
    Flash-->>ESP8266: {tx_id: "abc", qty: 3, dispensed: 2, state: "dispensing"}

    Note over ESP8266: Found incomplete transaction!<br/>Set state to "error"

    ESP8266->>ESP8266: state = "error"<br/>error_type = "reboot"<br/>dispensed = 2 (partial)

    Note over ESP8266: Motor stopped (GPIO LOW on boot)<br/>Ready to accept new transactions

    Client->>ESP8266: GET /dispense/abc<br/>(periodic polling)

    ESP8266-->>Client: 200 {state: "error", error: "reboot",<br/>quantity: 3, dispensed: 2}

    Note over Client: Record partial dispense:<br/>2 tokens dispensed<br/>Charge for 2 or issue refund
```

**Key Principles:**
- ✅ Flash persistence allows ESP8266 to report exact dispensed count
- ✅ Motor stops on reboot (GPIO default LOW)
- ✅ Client polls ESP8266 and handles partial dispense
- ✅ Customer only charged for tokens actually received

#### Protocol 3: Network Partition Recovery

**Trigger:** Client cannot reach ESP8266 for >3 minutes

**Actions:**

```mermaid
sequenceDiagram
    participant Monitor as System Monitor
    participant Client as Client App
    participant ESP8266

    Note over Monitor: ESP8266 health check failed<br/>3 consecutive timeouts

    Monitor->>Monitor: Alert: ESP8266 unreachable

    alt Network issue
        Note over Monitor: Wait for network restoration
        Monitor->>ESP8266: Retry GET /health
        ESP8266-->>Monitor: 200 {status: "ok", ...}
        Monitor->>Monitor: Alert resolved
    else ESP8266 actually offline
        Monitor->>Monitor: Alert: Manual intervention required
        Note over Monitor: Dispenser unavailable<br/>Report to external monitoring
    end

    Note over Client: Any pending transactions?
    Client->>Client: Check incomplete transactions

    alt No incomplete transactions
        Note over Client: Nothing to reconcile<br/>Wait for ESP8266 to come back
    else Has incomplete transaction
        Note over Client: Wait for ESP8266 connectivity
        Client->>ESP8266: GET /dispense/{tx_id}<br/>(when connection restored)
        Note over Client: Reconcile as per Protocol 1
    end
```

#### Protocol 4: Incomplete Transaction Detection

**Trigger:** System Monitor detects incomplete transactions count >0 for >5 minutes

**Actions:**

```
System Monitor Logic:

Every 60 seconds:
├─ Query: SELECT COUNT(*) FROM transactions
│         WHERE state IN ('pending', 'dispensing')
│         AND created_at < NOW() - INTERVAL 5 minutes
│
├─ If count > 0:
│   ├─ Log: "Detected {count} stuck transactions"
│   ├─ Alert to external monitoring
│   ├─ Check if client app is responsive
│   │   ├─ If unresponsive: Trigger client restart (Protocol 1)
│   │   └─ If responsive: Client should be handling recovery
│   └─ Check if ESP8266 is reachable
│       ├─ If unreachable: Alert "Network issue" (Protocol 3)
│       └─ If reachable: Client should reconcile
└─ If count = 0:
    └─ All transactions in final states (healthy)
```

**Reconciliation Triggers:**

1. **Client app restart** → Automatic reconciliation on boot
2. **System Monitor alert** → Forces client to reconcile
3. **Manual intervention** → Operator can trigger reconciliation

---

### Recovery Guarantees

The recovery protocols provide these guarantees:

**Customer Protection:**
- ✅ **Never double-charged**: Payment only created after confirming dispensed count
- ✅ **Accurate billing**: Charged for exact tokens received (including partial dispenses)
- ✅ **No phantom charges**: If dispense failed, no payment transaction exists

**Operational Recovery:**
- ✅ **Automatic recovery** from client crashes (watchdog restarts app)
- ✅ **Transaction reconciliation** on every client boot
- ✅ **Network resilience** through retry and idempotency
- ✅ **Hardware failure handling** via ESP8266 flash persistence

**Data Consistency:**
- ✅ **ESP8266 is source of truth** for dispense outcome
- ✅ **Client reconciles** local state with ESP8266 reality
- ✅ **No lost transactions** (all tracked in stable storage)
- ✅ **Audit trail** complete for all dispense attempts

**Failure Modes Handled:**
- ✅ Client app crash mid-dispense
- ✅ ESP8266 power loss mid-dispense
- ✅ Network partition during dispense
- ✅ Client reboot with incomplete transactions
- ✅ ESP8266 reboot with partial dispense
- ✅ Watchdog timeout (jams, stalls)

---

## Future Enhancements

Potential architectural extensions (not yet implemented):

1. **Multi-dispenser support** - Client manages multiple ESP8266 dispensers
2. **Remote management API** - Configuration updates over network
3. **Token type detection** - Different denominations
4. **Predictive maintenance** - ML-based jam prediction
5. **Mobile app integration** - Remote monitoring and alerts

---

## Summary

This architecture provides:

- ✅ **Reliability** through crash recovery and persistence
- ✅ **Idempotency** through transaction ID-based deduplication
- ✅ **Observability** through health monitoring and logging
- ✅ **Simplicity** through stateless HTTP protocol and single-phase dispense-first model
- ✅ **Safety** through exact token counting and flash persistence
- ✅ **Maintainability** through clear component separation

The system is designed to handle real-world conditions including power loss, network failures, and hardware faults while maintaining an accurate audit trail of all dispensing activity.
