dgloeckner/remote-token-dispenser/hardware/enclosure/einkaufsliste.md

# Einkaufsliste Gehäuse

Stand: 2026-09-20. Preise mit „ca.“ sind Schätzungen, die übrigen stammen von den verlinkten Seiten
(am 2026-09-20 abgerufen, können sich ändern). Zeichnungen: `front-view.svg`, `funnel.pdf`.

## 1. Schrank

| Pos. | Artikel | Menge | Preis | Quelle / Hinweis |
|---|---|---|---|---|
| 1.1 | Tibox Stahl-Schaltschrank 400×400×200, IP66 (ST4 420) | 1 | 42,99 € inkl. Versand | [eBay 147460354012](https://www.ebay.de/itm/147460354012) – Versand aus Litauen, Doppelbart-Vorreiber bleibt |

## 2. Verschluss (Detail B in `front-view.svg`)

| Pos. | Artikel | Menge | Preis | Quelle / Hinweis |
|---|---|---|---|---|
| 2.1 | ABUS Gelenk-Überfalle 110/155 | 1 | 14,37 € + Versand | [sicherheitsladen-gera.de](https://www.sicherheitsladen-gera.de/Zubehoer/Ueberfallen/ABUS-Gelenk-Ueberfalle-110-155::1240.html) |
| 2.2 | Vorhängeschloss, Bügel ≤ 10 mm (Öse hat 12 mm): ABUS Titalium 64TI/40 | 1 | ab ca. 6,50–10 € | [Geizhals](https://geizhals.de/abus-64-titalium-64ti-40hb40-54589-a1853867.html), [OBI](https://www.obi.de/vorhaengeschloesser/abus-titalium-vorhangschloss-64ti-40-b-sb/p/1377472). ABUS empfiehlt zur Überfalle das stärkere 80TI/40. Gleichschließend bestellen, falls mehrere Personen befüllen. |
| 2.3 | Schlossschrauben M5 × 16 (DIN 603), verzinkt oder A2 | 4 | ca. 2 € | Baumarkt. Falls der Kopf nicht in die Senkung der Überfalle passt: Senkschrauben M5 × 16 (ISO 10642). |
| 2.4 | Hutmuttern M5 (DIN 1587) | 4 | ca. 2 € | Baumarkt |
| 2.5 | U-Scheiben M5 (DIN 125) | 4 | ca. 1 € | Baumarkt |
| 2.6 | Flachstahl 60 × 3 mm, 0,5–1 m (ergibt 2 Gegenplatten à ca. 60 × 80) | 1 | ca. 5–8 € | Baumarkt – einfacher als Blechzuschnitt; Bohrungen Ø 5,5 nach Lochbild der Überfalle |

## 3. Elektronik-Einbau

| Pos. | Artikel | Menge | Preis | Quelle / Hinweis |
|---|---|---|---|---|
| 3.1 | Verdrahtungskanal 60 × 40 mm, geschlitzt, mit Deckel, 2 m (gebraucht werden ca. 36 cm) | 1 | ca. 8–17 € | z. B. [Hager BA760040 bei Mosel-Elektro (ca. 8,3 €/m)](https://mosel-elektro.de/installationsmaterial/rohre-&-kanäle/verdrahtungskanal/hager/hager-ba7/2m-hager-ba760040-verdrahtungskanal-pvc-ba7-60x40-sgrau-(806eurm)----115003.html), [tecedo.de](https://www.tecedo.de/tehalit-ba760040-verdrahtungskanal-60x40-114520.html), [Elektrofachmarkt-online](https://www.elektrofachmarkt-online.de/aufputzmaterial/weitere-kabelkanaele/verdrahtungskanal/Verdrahtungskanal-60x40mm---Laenge-2m.html). Wichtig: **geschlitzt** (Verdrahtungskanal), nicht der glatte Installationskanal. |
| 3.2 | Kabelbinder 2,5 × 100 mm (UV-/hitzebeständig egal, innen) | 1 Beutel | ca. 2 € | Platinen, Elko und Flachbandkabel im Kanal fixieren |
| 3.3 | Schrumpfschlauch Ø ca. 25–30 mm, 10 cm (für den Mini-360) + Sortiment klein | 1 | ca. 5 € | Wandler erst auf 5,0 V einstellen, Poti sichern, dann einschrumpfen |
| 3.4 | Moosgummi / Zellkautschuk selbstklebend, 3 mm | 1 Streifen | ca. 3 € | Abstand zwischen den Optokoppler-Modulen |
| 3.5 | KFZ-Flachsicherungshalter fliegend (ATO) mit Kabel | 1 | ca. 3–5 € | z. B. [Offgridtec](https://www.offgridtec.com/4-0mm2-standard-kfz-4mm-flachsicherungshalter-inkl.-kabel.html), [deuklar.de (2,95 €)](https://deuklar.de/KFZ-Sicherungshalter-wasserdicht) |
| 3.6 | KFZ-Flachsicherung 4 A (Standard/ATO), plus 1–2 Reserve | 3 | ca. 2 € | Hopper-Anlaufstrom laut Handbuch ca. 3 A kurzzeitig; träge genug ist die Flachsicherung. Löst sie beim Anlauf aus → 5 A. |
| 3.7 | Wago 221-412 / 221-413 Verbindungsklemmen | 5–10 | ca. 5 € | offene Drahtenden und 12-V-/GND-Verteilung; hält auch starren Draht |
| 3.8 | Kabelverschraubung M12 mit Gegenmutter | 1 | ca. 1–2 € | 12-V-Zuleitung unten rechts |
| 3.9 | Nagellack / Sicherungslack | 1 | vorhanden? | Trimmpoti am Wandler sichern |

## 4. Münzweg (Trichter und Schale, siehe `funnel.pdf`)

| Pos. | Artikel | Menge | Preis | Quelle / Hinweis |
|---|---|---|---|---|
| 4.1 | Alu-Blech 1 mm, mind. 200 × 250 mm | 1 | vorhanden | Teil A 116 × 186, Teil B 65 × 56 |
| 4.2 | Blindnieten Alu Ø 3,2 × 6 | 4 (+ Reserve) | vorhanden | Rampe an die Wangen |
| 4.3 | Schrauben M4 × 10 + Muttern + U-Scheiben | 6 | ca. 2 € | 2× Trichterfüße am Schrankboden, 4× Rückwand der Münzschale an der Tür |
| 4.4 | Münzschale ca. 120 × 35 × 55 mm mit Rückwand 120 × 93 | 1 | 0 € (selbst aus Alu-Blech) oder ca. 18 € | Fertigteil z. B. [Münzrückgabeschale bei espresso24.com (18,30 €)](https://espresso24.com/ersatzteile/crane-cms-teile/snackautomat/) – Maße vor dem Kauf prüfen, passt evtl. nicht zum Schlitz 40 × 32 |
| 4.5 | Pappe / Tetrapak für das 1:1-Probemodell | – | 0 € | erst testen (≥ 20 Münzen), dann Blech schneiden |

## 5. Schrank-Montage

| Pos. | Artikel | Menge | Preis | Quelle / Hinweis |
|---|---|---|---|---|
| 5.1 | Blindnieten Stahl oder Alu Ø 4 × 8 (oder M4-Schrauben) | 3 | vorhanden / ca. 1 € | Verdrahtungskanal an Rückwand bzw. Montageplatte |
| 5.2 | Schwerlastdübel + Schrauben passend zur Wand, z. B. 4× 8 × 60 mit großen U-Scheiben | 4 | ca. 5 € | Schrank **von innen** durch die Rückwand verschrauben |
| 5.3 | Kantenschutzprofil für 1–2 mm Blech, 0,5 m | 1 | ca. 3 € | Türschlitz 40 × 32 einfassen (Verletzungsschutz, Optik) |

## 6. Optional

| Pos. | Artikel | Menge | Preis | Hinweis |
|---|---|---|---|---|
| 6.1 | Reed-Kontakt / Türkontakt (NC oder NO) mit Magnet | 1 | ca. 3 € | Tür-offen-Meldung an freiem GPIO (z. B. D2) – Firmware-Erweiterung nötig |
| 6.2 | Steckernetzteil 12 V / 3 A | 1 | ca. 12 € | Reserve gegenüber 12 V / 2 A beim Motoranlauf |
| 6.3 | Wemos D1 mini Pro + U.FL-SMA-Pigtail + 2,4-GHz-Antenne | 1 | ca. 10 € | nur falls das WLAN bei geschlossener Tür nicht reicht |

## Summe

Pflichtpositionen ohne Vorhandenes: ca. **105–125 €** (Schrank 43 € + Verschluss ca. 30–35 € + Elektronik-Einbau ca. 30–40 € + Kleinteile).

## Werkzeug (nicht kaufen, nur bereitlegen)

Stufenbohrer oder Bohrer Ø 3,3 / 4,3 / 5,5 / 12; Stichsäge oder Flex für Türschlitz und Montageplatte; Feile/Entgrater;
Blindnietzange; Multimeter (5,0 V einstellen); Körner.
