dgloeckner/remote-token-dispenser/sauna_dispenser_enclosure_options.docx

# Sauna Token Dispenser — Enclosure Options

FRGS Rowing Club | Azkoyen Hopper U-II Housing | February 2026

Comparison of affordable metal junction boxes (Schaltschränke) available from German suppliers, suitable for housing the Azkoyen Hopper U-II coin mechanism with Wemos D1 controller. All prices include VAT unless noted.

## 1. Standard Size: 300×200×150 mm (H×B×T)

The most common and affordable size. Fits the Small hopper variant but may be tight with a fully loaded token bowl. Dimensions refer to H×B×T (wall-mounted orientation).

Enclosure | Size (mm) | IP Rating | Price | Details
eBay ekabel24 Stahlblech IP65 | 300x200x150 | IP65 | ~€30–35 | Best value option 1.2mm Stahlblech, IK10, RAL 7035 Incl. Montageplatte (verzinkt, 2mm) Free international shipping ebay.de/itm/174579843200
Schaltschrank-Xpress Stahlblech IP66 | 300x200x150 | IP66 | ~€45–49 | Best quality/price ratio VDE & UL certified 1.5–2mm cold-rolled steel 5mm Doppelbart lock + 2 keys Cable entry plates included schaltschrank-xpress.de
Amazon.de Werner GmbH | 300x200x150 | IP65 | ~€30–40 | Fastest delivery (Prime) 4-Punkt Schließung, 2 Schlüssel 2x Kabeleinlässe 100x53mm 1.2mm Stahlblech, pulverbeschichtet Amazon ASIN: B00XUD1TJK
Kaufland.de IP66 Metall | 300x200x150 | IP66 | ~€39–44 | Good middle option IP66, IK10 Schlagfestigkeit EN 62208, EN 60439 certified kaufland.de/product/484011601
BOXEXPERT Treva-INOX (Edelstahl) | 300x200x150 | IP66 | ~€60–80 | Premium / humid environments AISI 304L stainless steel Satiniert finish, won’t rust Best for near-sauna placement boxexpert.de

## 2. Larger Alternatives (Recommended)

If the 150mm depth is too tight for the hopper bowl with tokens, consider these slightly larger options. The price difference is minimal (€5–10 more) and the extra space makes assembly and maintenance much easier.

Enclosure | Size (mm) | IP Rating | Price | Details
Schaltschrank-Xpress 300x300x150 | 300x300x150 | IP66 | ~€54 | 50mm more width for hopper bowl Same build quality as 300x200x150
ekabel24 300x200x200 | 300x200x200 | IP65 | ~€35–40 | 50mm deeper — more room for bowl height Recommended if using Medium hopper
ekabel24 300x250x200 UL | 300x250x200 | IP65 | ~€40–45 | Extra width + depth, UL certified Most comfortable fit for all components

## 3. WiFi Considerations

All metal Schaltschränke act as Faraday cages and will block the Wemos D1’s WiFi signal. Solutions (from simplest to most robust):

- Cut a “WiFi window” (~40×30mm hole) in the back panel, cover with acrylic or thin plastic. Cheapest and simplest.
- Position the Wemos near a cable entry knockout and leave it covered with the plastic blanking plate (not metal).
- Upgrade to a Wemos D1 Mini Pro with external U.FL antenna connector. Route SMA pigtail through grommet hole. Best range (~€5–8 extra).
- Test signal through the door gasket gap first — if the router is nearby (<5m, same room), it may work without modification.

## 4. Required Modifications

Regardless of which enclosure you choose, the following modifications are needed:

- Token exit slot: Cut ~30×15mm slot in the side or front wall, aligned with the hopper’s coin exit point.
- Power cable entry: Use existing cable entry knockouts or drill a 10mm grommet hole in the bottom/back.
- Ventilation: Drill 4–6 holes (8mm each) in the back panel for airflow around the 12V PSU and motor.
- Token tray: Mount a small stainless steel cup or L-bracket below the exit slot on the outside.
- WiFi window: One of the solutions above to ensure Wemos D1 connectivity.

## 5. Recommendation

For the FRGS sauna token dispenser, the Schaltschrank-Xpress IP66 in 300×200×150mm (~€49) offers the best combination of build quality, included accessories (lock, mounting plate, cable entries), and VDE/UL certification. If the 150mm depth feels too tight after measuring with your hopper variant, step up to the ekabel24 300×250×200mm (~€40–45) for maximum internal room. For placement near the sauna (humid environment), the BOXEXPERT Edelstahl variant is worth the premium to prevent corrosion.
