dgloeckner/remote-token-dispenser/hardware/enclosure/front-view.png

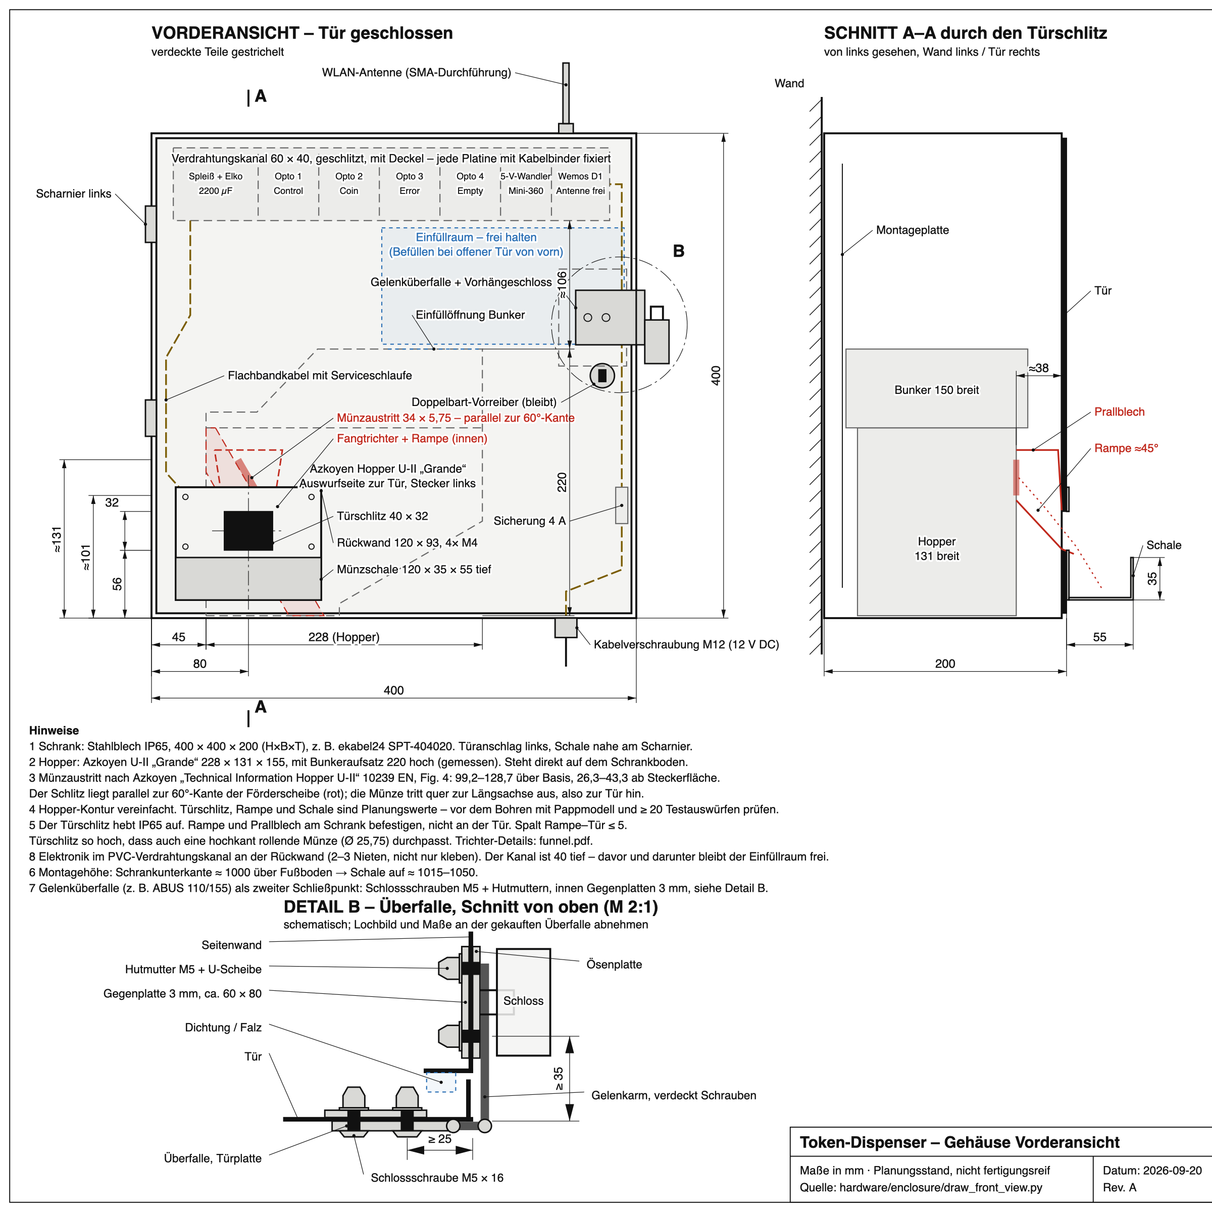
hardware/enclosure/front-view.png
