dgloeckner/remote-token-dispenser/hardware/enclosure/funnel.pdf

## Teil A – Gehäuse (Abwicklung 1:1)

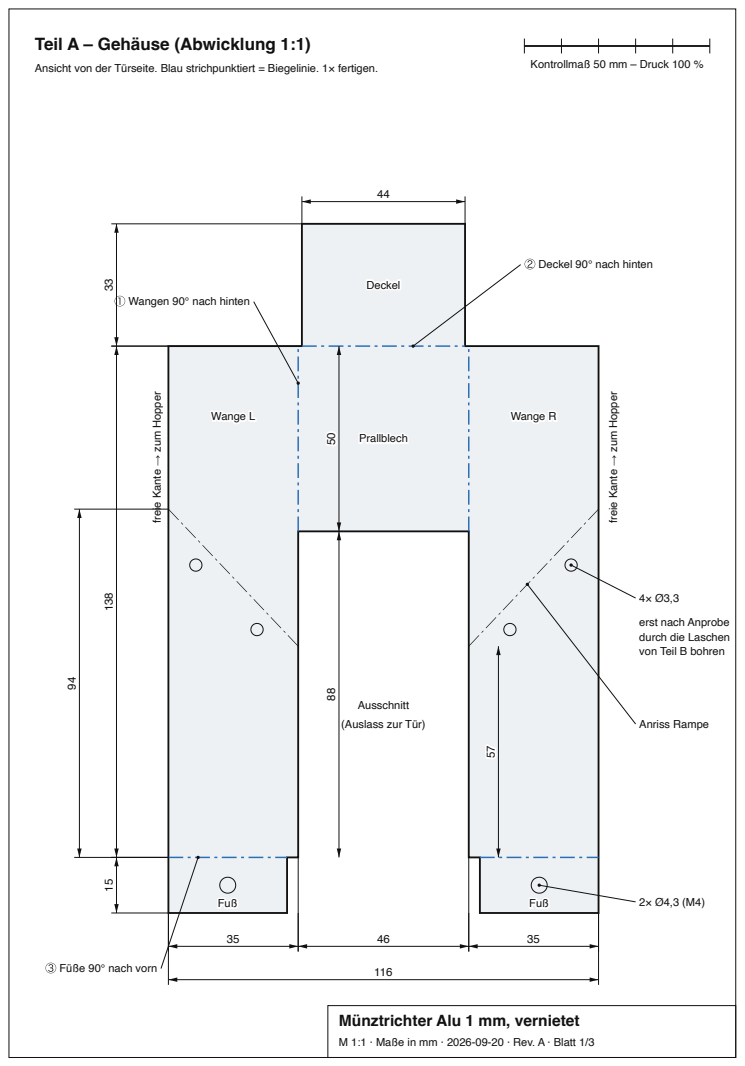
[picture p8: page 1]
Ansicht von der Türseite. Blau strichpunktiert = Biegelinie. 1× fertigen..; Kontrollmaß 50 mm – Druck 100 %%; Wange L; Wange R; Prallblech; Deckel; Fuß; Ausschnitt; (Auslass zur Tür)); freie; Kante; zum; Hopper; Anriss Rampe

② Deckel 90° nach hinten

① Wangen 90° nach hinten

Hopper freie Kante → zum

erst nach Anprobe
durch die Laschen
von Teil B bohren

③ Füße 90° nach vorn

Münztrichter Alu 1 mm, vernietet

M 1:1 · Maße in mm · 2026-09-20 · Rev. A · Blatt 1/3

## Teil B – Rampe (Abwicklung 1:1)

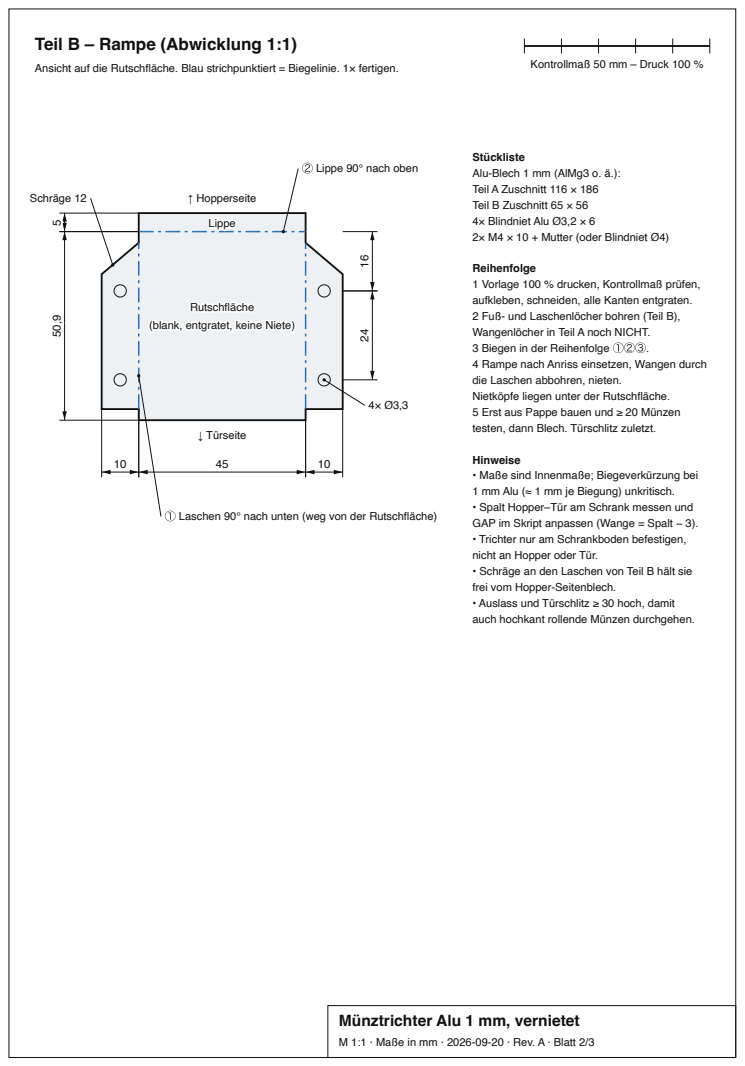
[picture p9: page 2]
AAnnssiicchhtt aauuff ddiiee RRuuttsscchhflflääcchhee.. BBllaauu ssttrriicchhppuunnkkttiieerrtt == BBiieeggeelliinniiee.. 11×× ffeerrttiiggeenn..; KKoonnttrroollllmmaaßß 5500 mmmm –– DDrruucckk 110000 %%; RRuuttsscchhflflääcchhee; Liippe; ↓↓ TTüürrsseeiittee; ↑↑ HHooppppeerrsseeiittee; SScchhrrääggee 1122

Stückliste
Alu-Blech 1 mm (AlMg3 o. ä.):
Teil A Zuschnitt 116 × 186
Teil B Zuschnitt 65 × 56
4× Blindniet Alu Ø3,2 × 6
2× M4 × 10 + Mutter (oder Blindniet Ø4)

② Lippe 90° nach oben

Reihenfolge
1 Vorlage 100 % drucken, Kontrollmaß prüfen,
aufkleben, schneiden, alle Kanten entgraten.
2 Fuß- und Laschenlöcher bohren (Teil B),
Wangenlöcher in Teil A noch NICHT.
3 Biegen in der Reihenfolge ①②③.
4 Rampe nach Anriss einsetzen, Wangen durch
die Laschen abbohren, nieten.
Nietköpfe liegen unter der Rutschfläche.
5 Erst aus Pappe bauen und ≥ 20 Münzen
testen, dann Blech. Türschlitz zuletzt.

(blank, entgratet, keine Niete)

Hinweise
• Maße sind Innenmaße; Biegeverkürzung bei
1 mm Alu (≈ 1 mm je Biegung) unkritisch.
• Spalt Hopper–Tür am Schrank messen und
GAP im Skript anpassen (Wange = Spalt − 3).
• Trichter nur am Schrankboden befestigen,
nicht an Hopper oder Tür.
• Schräge an den Laschen von Teil B hält sie
frei vom Hopper-Seitenblech.
• Auslass und Türschlitz ≥ 30 hoch, damit
auch hochkant rollende Münzen durchgehen.

① Laschen 90° nach unten (weg von der RRuuttsscchhflflääcchhee))

Zusammenbau – Schnitt durch die Trichtermitte (1:1)

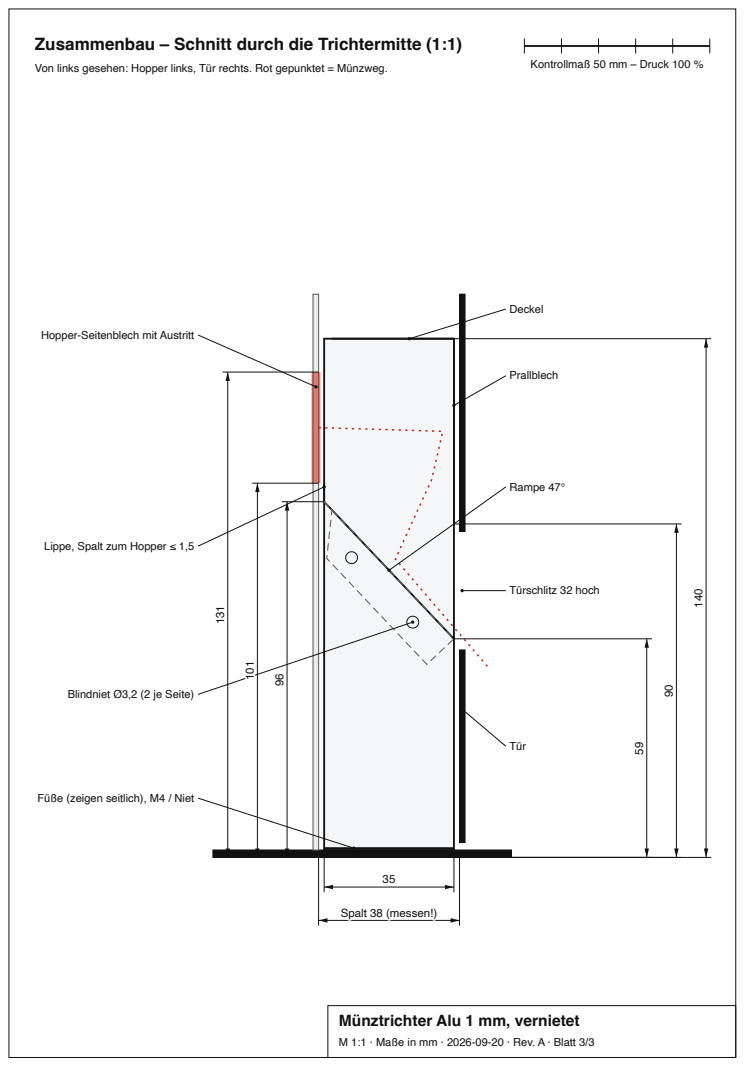
[picture p10: page 3]
Von links gesehen: Hopper links, Tür rechts. Rot gepunktet = Münzweg..; Kontrollmaß 50 mm – Druck 100 %%; Prallblech; Deckel; Rampe 47°°; Türr; Türschlitz 32 hoch; Spalt 38 (messen!)

Hopper-Seitenblech mit Austritt

Lippe, Spalt zum Hopper ≤ 1,5

Blindniet Ø3,2 (2 je Seite)

Füße (zeigen seitlich), M4 / Niet
