dgloeckner/remote-token-dispenser/firmware/dispenser/dispense_manager.cpp

// firmware/dispenser/dispense_manager.cpp

#include "dispense_manager.h"
#include <string.h>

DispenseManager::DispenseManager(FlashStorage& storage, HopperControl& hopper)
  : flashStorage(storage), hopperControl(hopper) {
  memset(&active_tx, 0, sizeof(active_tx));
  active_tx.state = STATE_IDLE;

  memset(history, 0, sizeof(history));
  history_index = 0;

  total_dispenses = 0;
  successful_count = 0;
  jam_count = 0;
  partial_count = 0;
  crash_count = 0;
  requested_tokens = 0;
  dispensed_tokens = 0;
}

void DispenseManager::begin() {
  // Load persisted transaction if exists
  if (flashStorage.hasPersistedTransaction()) {
    PersistedTransaction persisted = flashStorage.load();

    // Copy to active transaction
    strncpy(active_tx.tx_id, persisted.tx_id, 16);
    active_tx.tx_id[16] = '\0';
    active_tx.quantity = persisted.quantity;
    active_tx.dispensed = persisted.dispensed;
    active_tx.state = persisted.state;

    // Handle recovery scenarios
    if (active_tx.state == STATE_DISPENSING) {
      // Crashed during dispense - mark as error
      active_tx.state = STATE_ERROR;
      persistActiveTransaction();

      // Count the crashed transaction
      total_dispenses++;                   // Transaction was started before crash
      crash_count++;                       // Track crash specifically
      requested_tokens += active_tx.quantity;   // Add requested tokens
      dispensed_tokens += active_tx.dispensed;  // Add partial dispense

      Serial.print("Recovered from crash during dispense. Partial count: ");
      Serial.println(active_tx.dispensed);
    } else if (active_tx.state == STATE_ERROR) {
      // Power cycled to clear jam - manual reset
      Serial.println("Clearing previous error state (manual reset via power cycle)");
      flashStorage.clear();
      memset(&active_tx, 0, sizeof(active_tx));
      active_tx.state = STATE_IDLE;
    }

    // Add to history with full transaction data
    addToHistory(active_tx.tx_id, active_tx.state, active_tx.quantity, active_tx.dispensed);
  }
}

bool DispenseManager::startDispense(const char* tx_id, uint8_t quantity) {
  Serial.println("[DispenseManager] startDispense() called");
  Serial.print("  tx_id: ");
  Serial.println(tx_id);
  Serial.print("  quantity: ");
  Serial.println(quantity);

  // Check if already in history (idempotency)
  Transaction cached_tx;
  if (findInHistory(tx_id, cached_tx)) {
    // Return cached result
    Serial.println("  Transaction found in history (idempotent request)");
    active_tx = cached_tx;
    return true;  // Not an error, just idempotent
  }

  // Check if busy
  if (active_tx.state == STATE_DISPENSING) {
    Serial.println("  ERROR: Already dispensing, rejecting request");
    return false;  // 409 Conflict
  }

  // Start new transaction
  Serial.println("  Starting new dispense transaction");
  strncpy(active_tx.tx_id, tx_id, 16);
  active_tx.tx_id[16] = '\0';
  active_tx.quantity = quantity;
  active_tx.dispensed = 0;
  active_tx.state = STATE_DISPENSING;
  active_tx.started_ms = millis();

  // Persist to flash
  Serial.println("  Persisting transaction to flash...");
  persistActiveTransaction();

  // Arm ISR-level stop BEFORE starting motor so the very first pulse that
  // reaches the target immediately cuts motor power, eliminating the ~10ms
  // main-loop latency that was causing occasional double-dispenses.
  Serial.println("  Resetting pulse count and starting motor...");
  hopperControl.resetPulseCount();
  hopperControl.setMotorStopAt(quantity);
  hopperControl.startMotor();

  // Update metrics
  total_dispenses++;
  requested_tokens += quantity;

  Serial.println("[DispenseManager] Dispense started successfully");
  return true;
}

void DispenseManager::loop() {
  if (active_tx.state != STATE_DISPENSING) {
    return;  // Nothing to monitor
  }

  // Update dispensed count from pulse counter
  uint8_t previous_count = active_tx.dispensed;
  active_tx.dispensed = hopperControl.getPulseCount();

  // Log pulse count changes
  if (active_tx.dispensed != previous_count) {
    Serial.print("[DispenseManager] Pulse count: ");
    Serial.print(active_tx.dispensed);
    Serial.print(" / ");
    Serial.println(active_tx.quantity);
  }

  // Check for completion
  if (active_tx.dispensed >= active_tx.quantity) {
    Serial.println("[DispenseManager] Dispense COMPLETE!");
    hopperControl.stopMotor();
    active_tx.state = STATE_DONE;

    // Clear active error on successful completion (self-healing)
    hopperControl.errorHistory.clearActive();

    persistActiveTransaction();
    addToHistory(active_tx.tx_id, STATE_DONE, active_tx.quantity, active_tx.dispensed);

    // Track dispensed tokens
    dispensed_tokens += active_tx.dispensed;

    flashStorage.clear();
    memset(&active_tx, 0, sizeof(active_tx));
    active_tx.state = STATE_IDLE;
    successful_count++;
    Serial.println("[DispenseManager] Dispense complete - active error cleared");
    return;
  }

  // Check for jam
  if (hopperControl.checkJam()) {
    Serial.println("[DispenseManager] JAM DETECTED!");
    Serial.print("  Dispensed: ");
    Serial.print(active_tx.dispensed);
    Serial.print(" / ");
    Serial.println(active_tx.quantity);
    hopperControl.stopMotor();
    active_tx.state = STATE_ERROR;
    persistActiveTransaction();
    addToHistory(active_tx.tx_id, STATE_ERROR, active_tx.quantity, active_tx.dispensed);
    jam_count++;

    // Track dispensed tokens even on jam (partial dispense)
    dispensed_tokens += active_tx.dispensed;

    if (active_tx.dispensed > 0) {
      partial_count++;
    }

    // Stay in ERROR state - requires power cycle to clear
    return;
  }
}

Transaction DispenseManager::getTransaction(const char* tx_id) {
  // Check active transaction
  if (strcmp(active_tx.tx_id, tx_id) == 0) {
    return active_tx;
  }

  // Check history
  Transaction cached_tx;
  if (findInHistory(tx_id, cached_tx)) {
    return cached_tx;
  }

  // Not found - return empty with IDLE state
  Transaction empty_tx;
  memset(&empty_tx, 0, sizeof(empty_tx));
  empty_tx.state = STATE_IDLE;
  return empty_tx;
}

Transaction DispenseManager::getActiveTransaction() {
  return active_tx;
}

bool DispenseManager::isIdle() {
  return active_tx.state != STATE_DISPENSING;
}

uint16_t DispenseManager::getTotalDispenses() { return total_dispenses; }
uint16_t DispenseManager::getSuccessful() { return successful_count; }
uint16_t DispenseManager::getJams() { return jam_count; }
uint16_t DispenseManager::getPartial() { return partial_count; }
uint16_t DispenseManager::getCrashes() { return crash_count; }
uint32_t DispenseManager::getRequestedTokens() { return requested_tokens; }
uint32_t DispenseManager::getDispensedTokens() { return dispensed_tokens; }

// Private methods
bool DispenseManager::findInHistory(const char* tx_id, Transaction& out_tx) {
  for (int i = 0; i < RING_BUFFER_SIZE; i++) {
    if (strcmp(history[i].tx_id, tx_id) == 0) {
      // Found in history - return complete transaction data
      memset(&out_tx, 0, sizeof(out_tx));
      strncpy(out_tx.tx_id, tx_id, 16);
      out_tx.tx_id[16] = '\0';
      out_tx.state = history[i].state;
      out_tx.quantity = history[i].quantity;
      out_tx.dispensed = history[i].dispensed;
      return true;
    }
  }
  return false;
}

void DispenseManager::addToHistory(const char* tx_id, TransactionState state, uint8_t quantity, uint8_t dispensed) {
  strncpy(history[history_index].tx_id, tx_id, 16);
  history[history_index].tx_id[16] = '\0';
  history[history_index].state = state;
  history[history_index].quantity = quantity;
  history[history_index].dispensed = dispensed;
  history_index = (history_index + 1) % RING_BUFFER_SIZE;
}

void DispenseManager::persistActiveTransaction() {
  PersistedTransaction persisted;
  strncpy(persisted.tx_id, active_tx.tx_id, 16);
  persisted.tx_id[16] = '\0';
  persisted.quantity = active_tx.quantity;
  persisted.dispensed = active_tx.dispensed;
  persisted.state = active_tx.state;

  flashStorage.persist(persisted);
}
