dgloeckner/remote-token-dispenser/(commit log)

2026-02-08 Add ESP8266 firmware design and setup documentation
    - Complete design document for Wemos D1 Mini (ESP8266) firmware
    - Component-based architecture with 6 modules
    - GPIO pin assignments using D-labels (D5-D8)
    - API key authentication (X-API-Key header)
    - Watchdog jam detection and crash recovery
    - Comprehensive README with library requirements
    - Arduino IDE setup instructions
    - Updated ARCHITECTURE.md with API authentication
2026-02-08 fix: expand ring buffer to store complete transaction data
    - Replace separate tx_history[] and history_states[] arrays with unified HistoryEntry struct
    - HistoryEntry now stores: tx_id, state, quantity, dispensed (20 bytes per entry)
    - Update findInHistory() to return complete transaction data
    - Update addToHistory() to store all transaction fields
    - Update all addToHistory() calls to pass quantity and dispensed
    - Fixes idempotent retries returning quantity=0, dispensed=0
    Memory impact: +24 bytes RAM (160 vs 136 bytes for 8 entries)
    Resolves issue where retries of completed transactions showed incorrect data
    [dispense_manager.cpp, dispense_manager.h]
2026-02-09 Add wiring diagram generation system
    - Created docs/generate_diagrams.py using schemdraw library
    - Generated 3 SVG diagrams:
    - wiring-diagram.svg: ESP8266 ↔ Azkoyen Hopper U-II connections
    - pinout-diagram.svg: Wemos D1 Mini pinout with used pins highlighted
    - power-diagram.svg: Power supply and grounding connections
    - Added docs/README-diagrams.md with regeneration instructions
    - Updated .gitignore to exclude .venv and fix firmware path
    Diagrams are code-generated for version control and reproducibility.
2026-02-09 Add comprehensive hardware setup guide
    - Created hardware/README.md with detailed assembly instructions
    - Includes component list with cost estimates (~€170-220)
    - Step-by-step wiring and assembly instructions
    - Safety considerations (electrical, mechanical, token handling)
    - Troubleshooting guide for common issues
    - Assembly checklist for deployment
    - Links to all wiring diagrams (wiring, pinout, power)
    - Updated main README.md to reference hardware guide
    The hardware guide provides everything needed to physically assemble
    the token dispenser system from components.
2026-02-09 Fix Azkoyen Hopper U-II cost estimate
    Updated cost from €150-200 to €30 (used market price).
    Total project cost now ~€50-60 instead of €170-220.
2026-02-09 Fix diagram label positioning issues
    Removed all manually positioned text labels that were appearing
    scattered across the diagrams. The diagrams now only contain:
    - Component labels (properly attached to elements)
    - Wire signal labels (3.3V, 12V, pulse descriptions)
    - Pin labels (attached to IC pins)
    This dramatically reduces diagram height and improves readability.
    Notes and explanations are better placed in the documentation
    rather than cluttering the diagrams.
2026-02-09 Increase component sizes for better label readability
    Increased IC component dimensions across all diagrams:
    Wiring diagram:
    - ESP8266: w=3→5, pinspacing=1.2→1.8, edgepadH=0.5→1.0
    - Hopper: w=2.5→4.0, pinspacing=1.2→1.8, edgepadH=0.5→1.0
    Pinout diagram:
    - Board: w=5→8, pinspacing=0.9→1.4, edgepadH=0.8→1.2
    Power diagram:
    - ESP8266: w=1.5→3.0, pinspacing=1→1.5
    - PSU: w=1.5→3.0, pinspacing=1→1.5
    - Hopper: w=2→3.5, pinspacing=1→1.5
    Components now have sufficient space for labels without overlap.
2026-02-09 Move diagram titles higher above circuits
    Increased vertical spacing between titles and circuits from -1 to -2.5
    units across all three diagrams. Titles are now positioned well above
    the circuit elements for better visual separation and readability.
    Applied to:
    - Wiring diagram: "ESP8266 ↔ Azkoyen Hopper U-II Wiring"
    - Pinout diagram: "Wemos D1 Mini Pinout Reference"
    - Power diagram: "Power Supply Wiring"
2026-02-09 Increase Hopper component sizes to fix label overlap
    Significantly increased Azkoyen Hopper component dimensions to
    prevent label overlap with pin labels:
    Wiring diagram Hopper:
    - w: 4.0→6.0 (50% larger)
    - pinspacing: 1.8→2.2
    - edgepadH: 1.0→1.5
    Power diagram Hopper:
    - w: 3.5→5.0 (43% larger)
    - pinspacing: 1.5→2.0
    The multi-line "Azkoyen\nHopper U-II" label now has sufficient
    space and won't overlap with pin labels (Motor Enable, Pulse Out,
    Hopper Low, GND, 12V Power).
2026-02-09 Adjust Hopper component label position to avoid pin overlap
    Moved Azkoyen Hopper component labels upward to prevent overlap
    with pin labels:
    - Wiring diagram: lblofst 0 → -0.5 (label moved up)
    - Power diagram: lblofst 0 → -0.3 (label moved up)
    The component label "Azkoyen\nHopper U-II" is now positioned
    higher within the component box, clearing the "Motor" pin label
    on the right side.
2026-02-09 Fix power diagram: add voltage regulator and proper capacitor grounding
    Critical corrections to power supply wiring:
    1. ESP8266 power source correction:
    - Removed incorrect "USB" power input
    - Added voltage regulator (12V→5V) between PSU and ESP8266
    - 12V PSU now splits to: voltage regulator AND hopper
    2. Capacitor grounding fix:
    - Capacitor now properly connects between 12V and common GND
    - Added explicit connection from capacitor ground to common ground
    - All grounds (PSU, regulator, ESP8266, hopper, capacitor) connected
    to common ground point
    The diagram now accurately reflects the actual hardware setup where
    the ESP8266 is powered by a voltage regulator from t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
2026-02-09 Rewrite wiring diagram with accurate circuit from azkoyen_wemos_wiring_v2.pdf
    Complete rewrite of wiring diagram to match the actual hardware design:
    **Correct Pin Mapping:**
    - D1 (GPIO5) - Control output (via BC547 transistor)
    - D2 (GPIO4) - Coin pulse input (via voltage divider)
    - D5 (GPIO14) - Error signal input (via voltage divider)
    - D6 (GPIO12) - Empty signal input (via voltage divider)
    **Control Output Circuit:**
    - BC547 NPN transistor in open-collector configuration
    - R1: 1kΩ base resistor (Wemos D1 → transistor base)
    - R2: 10kΩ pull-up to 12V (transistor collector → hopper Control pin)
    - Wemos HIGH → transistor ON → Control pulled to GND = hopper active
    **Input Signal C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
2026-02-09 Update hardware documentation and pinout to match actual wiring
    Synchronized all documentation with azkoyen_wemos_wiring_v2.pdf:
    **Pin Assignment Changes:**
    OLD → NEW
    - D5 (GPIO14) Motor → D1 (GPIO5) Control output
    - D6 (GPIO12) Pulse → D2 (GPIO4) Coin input
    - D8 (GPIO15) Low → D5 (GPIO14) Error input
    - (new) → D6 (GPIO12) Empty input
    **Pin Safety Verification:**
    All pins are safe for ESP8266 (no boot mode conflicts):
    ✅ GPIO5 (D1) - General purpose, no restrictions
    ✅ GPIO4 (D2) - General purpose, no restrictions
    ✅ GPIO14 (D5) - General purpose, no restrictions
    ✅ GPIO12 (D6) - General purpose, no restrictions
    **Updated in hardware/README.md:**
    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
2026-02-09 Show complete hopper connector pinout in wiring diagram
    Updated wiring diagram to display all actual hopper connector pins:
    **Hopper Connector (2x5 Molex):**
    - VCC (1), VCC (2), VCC (3) - Three 12V power pins (top)
    - GND (3), GND (4) - Two ground pins (left side)
    - Control (5) - Dispense command input (left side)
    - Coin (6) - Pulse output per dispensed coin (right side)
    - H Level (7) - Hopper full detection (right side, optional)
    - Error (8) - Jam/motor error signal (right side)
    - Empty (9) - Coin bay empty signal (right side)
    **Connection Flow:**
    - All 3 VCC pins connected together to +12V supply
    - Both GND pins connected together to common ground
    - Control pin ← BC547 collector (via 10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
2026-02-09 Update hardware/README.md with all wiring diagrams and hopper pinout
    Added comprehensive wiring diagram section with visual references:
    **New additions:**
    - Azkoyen Hopper connector pinout photo (azkoyen-pinout.jpg)
    - Complete pinout description (VCC×3, GND×2, Control, Coin, H Level, Error, Empty)
    **Updated diagram sections:**
    - Main wiring diagram (wiring-diagram.svg) with BC547 + voltage dividers
    - Pinout reference (pinout-diagram.svg) with correct pins highlighted
    - Power supply diagram (power-diagram.svg) with voltage regulator
    **Enhanced descriptions:**
    - Detailed component values (R1: 1kΩ, R2: 10kΩ, R3-R8: voltage dividers)
    - Signal direction indicators (← input, → output)
    -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
2026-02-09 Fix stale pin references to match wiring diagram (source of truth)
    Updated all documentation to match wiring-diagram.svg pin assignments:
    **Corrected Pin Assignments:**
    D5 (GPIO14) Motor → D1 (GPIO5) Control output (via BC547)
    D6 (GPIO12) Pulse → D2 (GPIO4) Coin input (via voltage divider)
    D8 (GPIO15) Low → D5 (GPIO14) Error input (via voltage divider)
    (none) → D6 (GPIO12) Empty input (via voltage divider)
    **Updated Files:**
    - firmware/README.md: Pin definitions, mapping table, troubleshooting
    - README.md: Quick start wiring section
    **Key Changes:**
    - Removed relay/level shifter references → BC547 transistor
    - Added voltage divider specifications (10kΩ/3.3kΩ)
    - Upd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
2026-02-09 Add resistor combination options for voltage dividers
    Added comprehensive resistor configuration guide with two options:
    **Option A: Series Combination (2kΩ + 1kΩ + 330Ω = 3.33kΩ)**
    - Best for common resistor values
    - 14 resistors total
    - 3 resistors per voltage divider bottom
    **Option B: Parallel Combination (10kΩ || 5kΩ = 3.33kΩ)**
    - Best if you have many 10kΩ and 5kΩ resistors
    - 11 resistors total (3 fewer)
    - 2 resistors per voltage divider bottom
    **Includes:**
    - ASCII circuit diagrams for both options
    - Complete bill of materials for each option
    - Voltage calculations (both give 3.0V from 12V input)
    - Clear guidance on when to use each option
    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
2026-02-10 Migrate to optocoupler-based hardware design (PC817)
    Replace BC547 transistor circuit with PC817 optocoupler modules for
    galvanic isolation between ESP8266 (3.3V) and Azkoyen Hopper (12V).
    Hardware changes:
    - Use 4× PC817 optocoupler modules (bestep brand) with onboard resistors
    - Remove all discrete resistors (R1-R8 no longer needed)
    - Add optocoupler photo and update wiring diagrams
    Firmware changes:
    - Update pin assignments: D5→D1, D6→D2, D7→D5, D8→D6
    - Invert motor control logic (LOW=ON, HIGH=OFF)
    - All input signals now active LOW
    - Maintain FALLING edge interrupt (correct for optocoupler inversion)
    Documentation updates:
    - hardware/README.md: Replace transistor sections wit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
    [config.h, hopper_control.cpp]
2026-02-10 Fix Azkoyen connector pin assignments
    Correct hopper connector pinout to match actual hardware:
    - Pin 7: Control (was incorrectly at pin 8)
    - Pin 8: Error (was incorrectly at pin 7)
    - Pin 9: Coin (was incorrectly at pin 10)
    - Pin 10: Empty (was incorrectly at pin 9)
    Updated:
    - Wiring diagram: Swapped connector pin labels and wire routing
    - hardware/README.md: Corrected pin table with sequential numbering
    All four optocoupler modules now connect to correct hopper pins.
2026-02-10 Flip sensor optocouplers for cleaner wiring diagram
    Flip modules #2, #3, #4 (Coin, Error, Empty) so INPUT side faces
    hopper and OUTPUT side faces ESP8266. This makes the wiring much
    easier to read - hopper signals now flow directly to optocoupler
    inputs without crossing over the modules.
    Module #1 (Control) remains unchanged with INPUT on ESP side and
    OUTPUT on hopper side, which is correct for the control signal flow.
2026-02-11 Add design for GPIO pin status in health endpoint
    Documents extension of /health endpoint to expose real-time GPIO states
    for coin_pulse, error_signal, and hopper_low pins with both raw and
    logical values for debugging.
2026-02-11 Extend health endpoint with GPIO pin states
    Add real-time GPIO pin readings to /health endpoint for debugging and
    monitoring. Each pin now exposes both raw value (0/1) and logical state
    (active boolean).
    Changes:
    - Add HopperControl methods for reading all three input pins
    - Initialize ERROR_SIGNAL_PIN (was defined but not configured)
    - Restructure health response with nested gpio object
    - Breaking change: hopper_low moved from top-level to gpio.hopper_low
    Response structure:
    {
    "gpio": {
    "coin_pulse": {"raw": 1, "active": false},
    "error_signal": {"raw": 1, "active": false},
    "hopper_low": {"raw": 0, "active": true}
    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
    [hopper_control.cpp, hopper_control.h, http_server.cpp]
2026-02-13 docs: extract Azkoyen hopper protocol specification to markdown reference
    - Create docs/azkoyen-hopper-protocol.md from official PDF manual
    - Complete protocol specification: pinout, modes, signals, timing, errors
    - Document NEGATIVE mode requirement (critical for motor control)
    - Reference from CLAUDE.md as mandatory reading
    - Update Hardware Interfaces section with corrected information
    This protocol document is now the authoritative reference for all
    hopper-related development and troubleshooting.
2026-02-13 docs(plan): update hopper documentation plan with official protocol references
    - Add references to azkoyen-hopper-protocol.md throughout plan
    - Update voltage thresholds to match official spec (< 0.5V, > 4V)
    - Reference specific protocol sections for DIP switch, modes, voltages
    - Note protocol document already completed before plan execution
    - Ensure all technical details align with Azkoyen specifications
2026-02-13 docs(hardware): add critical warnings for NEGATIVE mode and optocoupler resistor modifications
    - Add prominent warning banner about NEGATIVE mode requirement
    - Document PC817 resistor modification requirements (R1 needs 330Ω parallel)
    - Add troubleshooting section for motor control issues
    - Explain voltage divider behavior with hopper input impedance
    These findings prevented hours of debugging and are critical for setup.
2026-02-13 docs(firmware): add critical hardware configuration requirements
    - Add warning section about NEGATIVE mode requirement before flashing
    - Document optocoupler resistor modification prerequisite (R1 330Ω parallel)
    - Update pin configuration table with complete D1 details and voltage thresholds
    - Add troubleshooting for motor control issues with multimeter verification steps
    - Clarify GPIO→optocoupler→hopper signal chain with NEGATIVE mode assumptions
    - Reference protocol doc section 2.1 for official voltage specifications
2026-02-13 docs: add critical prerequisites section for hopper NEGATIVE mode and resistor mod
    - Add prominent warning about NEGATIVE mode requirement
    - Document optocoupler modification as prerequisite
    - Link to detailed hardware setup guide
    - Prevent hours of debugging for new users
2026-02-13 docs(firmware): clarify optocoupler wiring and NEGATIVE mode requirement in config.h
    - Add critical hardware requirement warnings
    - Explain R1 modification necessity (13.3mA for saturation)
    - Document voltage ranges and why 6V HIGH is acceptable
    - Add NEGATIVE mode documentation comment
2026-02-13 docs(firmware): add detailed signal chain comments for motor control
    - Add file header explaining GPIO → optocoupler → hopper signal chain
    - Document voltage levels at each stage
    - Clarify NEGATIVE mode dependency
    - Add inline comments for startMotor/stopMotor explaining control flow
2026-02-13 docs: add comprehensive motor control troubleshooting guide
    - Document 4 most common motor control issues with solutions
    - Add diagnostic flowchart and voltage reference table
    - Include hardware modification checklist
    - Reduces debugging time from hours to minutes
    Based on real debugging session 2026-02-13.
2026-02-13 docs: document required wiring diagram annotations
    - List specific annotations for pinout-diagram-optocoupler.svg
    - List specific annotations for wiring-diagram-optocoupler.svg
    - Include exact text for warning callouts
    - Reference azkoyen-hopper-protocol.md sections for voltage thresholds
    - Note R1 modification (1kΩ || 330Ω = 248Ω → 13.3mA)
    - Note NEGATIVE mode requirement with DIP switch setting
2026-02-13 docs: add critical findings summary from debugging session
    Chronicle 4-hour debugging journey discovering:
    - Root cause #1: Hopper in POSITIVE mode instead of NEGATIVE
    - Root cause #2: Optocoupler R1 resistor too high (1kΩ → needs 330Ω parallel)
    Document symptoms, investigation timeline, breakthroughs, and lessons learned.
    Includes voltage measurements, signal chain analysis, and impact assessment.
    References azkoyen-hopper-protocol.md sections 2.1, 5, and 8 for specifications.
    Estimated time saved per future build: 3-4 hours
2026-02-13 docs(claude): add troubleshooting guide reference to protocol section
    - Link to motor-control-issues.md from azkoyen-hopper-protocol.md section
    - Completes cross-referencing between protocol doc and troubleshooting guide
    - Part of v1.0.0-critical-docs milestone
2026-02-13 docs: fix wiring diagram updates - correct German text and wrong BOM/VCC info
    - Fix incorrect 'no additional resistors needed' (330Ω IS required)
    - Fix incorrect 'Do not connect VCC' (VCC should be connected to 12V)
    - Translate German text to English in both diagrams
    - Critical corrections needed before adding new annotations
2026-02-13 docs: update wiring diagrams with critical hardware requirements
    Critical fixes:
    - Fix incorrect BOM: add 330Ω resistor requirement (was 'no additional resistors')
    - Fix VCC annotation: change from 'Do not connect' to 'Connect to 12V VCC'
    - Translate all German text to English
    - Fix CH1 header: change 'VCC: NC!' to 'R1 mod required!'
    New annotations:
    - Add NEGATIVE mode warning banner (red) to wiring diagram
    - Add R1 modification warning callout (orange) near optocoupler #1
    - Update logic notes with voltage levels (< 0.5V LOW, ~6V HIGH)
    - Add critical warning banner to pinout diagram
    - Add ⚠️ warning icon to D1 pin with 'R1 mod required!' note
    - Update legend with ⚠️ = Modification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
2026-02-13 fix: escape XML special characters in wiring diagram text
    Replace < with &lt; and > with &gt; in text elements:
    - Voltage thresholds (< 0.5V, > 4V)
    - Warning text about OUT voltage levels
    Fixes XML parser errors that broke SVG rendering
2026-02-13 docs: remove warning boxes from wiring diagram (not enough space)
    Remove:
    - R1 modification warning box
    - HOPPER DIP switch NEGATIVE mode warning box
    Keep critical info in:
    - CH1 header '(R1 mod required!)'
    - Updated BOM with 330Ω resistor
    - Updated logic notes with voltage levels
2026-02-13 docs: remove warning banner from pinout diagram (not enough space)
    - Critical warning banner at top
    Keep:
    - D1 pin ⚠️ icon and 'R1 mod required!' annotation
    - Updated legend with ⚠️ = Modification
    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
2026-02-14 fix(tui): correct coin pulse GPIO display logic
    Coin pulse is active-LOW, so active=true is the idle/default state,
    not an actual coin detection. The brief 30-65ms pulses show as
    active=false (pin goes HIGH during pulse).
    Display:
    - active=true (LOW/idle) → '○ idle (default)'
    - active=false (HIGH/pulse) → '● COIN DETECTED'
2026-02-14 fix(tui): clarify hopper low sensor interpretation
    The hopper low sensor triggers at a threshold (e.g., <10-20 coins),
    not when completely empty. Updated display to show 'below threshold'
    instead of 'empty' for clarity. Sensor is optional and threshold
    varies by hopper configuration.
2026-02-14 fix(tui): correct hopper empty sensor signal interpretation
    The Azkoyen hopper empty sensor (Pin 10) is a photocell at the
    bottom of the coin bay with inverted logic:
    - LOW (0V, active=true) = NOT empty (photocell blocked by coins)
    - HIGH (active=false) = empty (photocell sees light, no coins)
    Fixed both dashboard and GPIO debug displays to show correct status:
    - active=true → OK (has coins) ✓
    - active=false → EMPTY (no coins) ⚠
    Reference: azkoyen-hopper-protocol.md section 3.3
2026-02-14 docs(tui): note that empty sensor is optional
    Many Azkoyen hoppers don't have the empty sensor (Pin 10) installed.
    Added note in GPIO debug that sensor may not be present if signal
    doesn't change when adding/removing coins.
2026-02-14 docs: add hopper error decoding design spec
    Comprehensive design for implementing detailed error reporting:
    - Interrupt-driven pulse decoder for Azkoyen error codes 1-7
    - 5-error ring buffer with self-healing on successful dispense
    - Extended /health endpoint with error + error_history fields
    - TUI dashboard enhancements with error history panel
    Key decisions:
    - Non-blocking: allow dispense attempts with active errors
    - Self-healing: errors clear on successful dispense
    - Minimal memory: ~50 bytes for full implementation
2026-02-14 feat(firmware): add ErrorDecoder header with state machine
    - Define ErrorCode enum (codes 0-7 per Azkoyen protocol)
    - Define DecoderState enum for pulse counting state machine
    - ErrorDecoder class interface for interrupt-driven decoding
    - Helper functions for error code to string conversion
    [error_decoder.h]
2026-02-14 fix(firmware): add volatile qualifiers to shared state variables
    ErrorDecoder state variables are accessed from both ISR (handlePinChange)
    and main loop (update, getErrorCode, hasNewError). Without volatile,
    compiler optimizations could cause state machine to malfunction.
    Fixed:
    - volatile DecoderState state
    - volatile ErrorCode detectedCode
    - volatile bool newErrorReady
    [error_decoder.h]
2026-02-14 feat(firmware): implement ErrorDecoder state machine
    - Interrupt-safe handlePinChange() for FALLING/RISING edge detection
    - Start pulse validation: 90-110ms (100ms ±10%)
    - Code pulse validation: 8-12ms (10ms ±20%)
    - 200ms timeout for sequence completion
    - Error code conversion helpers (string/description)
    [error_decoder.cpp]
2026-02-14 fix(firmware): fix ISR safety issues in ErrorDecoder
    - Add noInterrupts() protection in update() for atomic lastPulseTime read
    - Add IRAM_ATTR to handlePinChange() (required for ESP8266 ISR)
    - Remove unused STATE_COUNTING and STATE_COMPLETE enum values
    Race condition: Multi-byte reads of volatile variables from ISR context
    need interrupt protection on ESP8266 to prevent torn reads.
    IRAM_ATTR: ESP8266 ISRs must run from IRAM to avoid crashes during
    flash operations (WiFi, HTTP, etc).
    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
    [error_decoder.cpp, error_decoder.h]
2026-02-14 feat(firmware): add ErrorHistory ring buffer
    - 5-error ring buffer with timestamp and cleared flag
    - addError() with automatic wrap-around
    - getActive() searches newest-first for non-cleared error
    - clearActive() marks active error as cleared
    - getAll() returns all errors for history display
    Memory: 5 × 6 bytes = 30 bytes
    [error_history.cpp, error_history.h]
2026-02-14 refactor(firmware): improve ErrorHistory maintainability
    - Add BUFFER_SIZE constant (eliminates 8 magic number instances)
    - Update index calculation for clarity: (writeIndex + BUFFER_SIZE - 1 - i) % BUFFER_SIZE
    - Document getAll() buffer size requirement
    - Use uint8_t loop variables for consistency
    No functional changes - pure refactoring for maintainability.
    [error_history.cpp, error_history.h]
2026-02-14 feat(firmware): integrate ErrorDecoder into HopperControl
    - Add ErrorDecoder and ErrorHistory instances to HopperControl
    - Attach CHANGE interrupt to ERROR_SIGNAL_PIN (D5/GPIO14)
    - ISR calls errorDecoder.handlePinChange()
    - updateErrorDecoder() polls for new errors and adds to history
    [hopper_control.cpp, hopper_control.h]
2026-02-14 feat(firmware): call updateErrorDecoder in main loop
    - Polls error decoder for timeout and new errors
    - Adds detected errors to history ring buffer
    [dispenser.ino]
2026-02-14 feat(firmware): clear active error on successful dispense
    - Call errorHistory.clearActive() on STATE_DONE transition
    - Self-healing: successful dispense proves recovery from error
    [dispense_manager.cpp]
2026-02-14 feat(firmware): extend /health endpoint with error fields
    - Add 'error' object with active/code/type/timestamp/description
    - Add 'error_history' array with last 5 errors
    - Backward compatible (new fields optional)
    Example response:
    "error": {"active": false},
    "error_history": []
    }
    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
    [http_server.cpp]
2026-02-14 feat(tui): add error history panel to dashboard
    - New renderErrorHistoryPanel showing last 5 errors
    - formatAge helper (seconds -> '5m ago' format)
    - Color coding: red for critical (codes 3-7), yellow for sensor (1-2)
    - Status indicator: ⚠ for active, ✓ for cleared
    - Positioned between latency and GPIO debug panels
2026-02-14 chore(firmware): bump version to 1.1.0-DEBUG-error-decoding
    Feature complete:
    - Error decoder with interrupt-driven state machine
    - 5-error ring buffer with self-healing
    - Extended /health endpoint
    - TUI error history panel
    [config.h]
2026-02-14 docs: add firmware build and upload guide
    Comprehensive arduino-cli documentation:
    - One-time setup (board support, libraries)
    - Building firmware (compile, clean build)
    - Uploading (port detection, upload options)
    - Serial monitoring (multiple tools)
    - Verification steps (ping, health endpoint, serial)
    - Troubleshooting (permissions, WiFi, common errors)
    - Quick reference commands
2026-02-14 fix(firmware): resolve naming conflicts for compilation
    - Rename DecoderState enum: STATE_IDLE -> DECODER_IDLE, STATE_START_PULSE -> DECODER_START_PULSE
    (conflicts with TransactionState in flash_storage.h)
    - Rename variable in http_server.cpp: active -> activeError
    (conflicts with Transaction active on line 73)
    Fixes compilation errors with arduino-cli.
    [error_decoder.cpp, error_decoder.h, http_server.cpp]
2026-02-14 docs: add comprehensive error signal wiring guide
    Detailed instructions for connecting hopper error signal:
    - Signal characteristics and timing
    - Step-by-step wiring (hopper → optocoupler → ESP8266)
    - Signal logic explanation (not inverted)
    - Testing without hopper (manual + Arduino simulator)
    - Verification steps (serial monitor + HTTP)
    - Troubleshooting common issues
    - Complete 4-signal reference table
2026-02-14 docs: add guide for safely triggering test errors
    Practical testing guide for all 7 error types:
    - Easiest: Error 6 (disconnect sensor), Error 7 (power fault)
    - Medium: Error 1 (coin stuck), Error 2 (sensor off), Error 3 (jam)
    - Skip: Error 4 (max span - too complex), Error 5 (motor - risky)
    - Recommended test sequence (easiest to hardest)
    - Arduino simulator sketch for testing without hopper
    - Verification checklist for each error
    - Safety warnings and pro tips
2026-02-16 docs: add mock dispenser design spec
    Comprehensive design for Go-based mock dispenser:
    - 15 test scenarios (success, failures, hardware errors)
    - Quantity-based scenario selection
    - Realistic timing (100ms/token, load delay)
    - Socket-level and protocol-level failure simulation
    - Dev-friendly defaults (:8080, api-key=dev)
    - No external dependencies
2026-02-16 fix(mock): correct type definitions per protocol spec
    - Remove ActiveTx from HealthResponse (not in spec)
    - Remove LastError/LastErrorType from Metrics (not in spec)
    - Fix ErrorInfo.Timestamp type (int64 → int)
    - Fix ErrorRecord.Timestamp type (int64 → int)
    - Add missing ActiveState to ErrorResponse
    All changes verified against dispenser-protocol.md v1.1.0.
    Timestamp fields now match spec definition of "integer" type
    representing seconds since boot.
2026-02-16 feat(mock): implement state management
    - MockDispenser struct for thread-safe state
    - Transaction history ring buffer (8 entries)
    - State tracking (idle/dispensing/done/error)
    - API key validation
2026-02-17 feat(mock): add CLI and server initialization
    - CLI flags: --bind, --api-key, --list-scenarios
    - HTTP server setup with routing
    - Scenario table printing
    - Server startup logging
2026-02-17 fix(mock): remove redundant os.Exit from printScenarios
    - main() already returns after calling printScenarios()
    - os.Exit makes the function untestable
2026-02-19 feat(dispenser): add token-level metrics and fix crash recovery tracking
    Add comprehensive metrics tracking for the dispenser system:
    Token-level metrics:
    - requested_tokens: Total tokens requested across all transactions
    - dispensed_tokens: Total tokens actually dispensed
    - Enables tracking token loss: requested - dispensed
    Transaction-level metrics:
    - crashes: New counter for crash recoveries during dispense
    - Existing: total_dispenses, successful, jams, partial, failures
    Bug fix:
    - Crash recovery now properly increments metrics (total_dispenses,
    crash_count, requested_tokens, dispensed_tokens)
    - Crashed transactions are now counted in the failures calculation
    Test infrastructure:
    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
    [dispense_manager.cpp, dispense_manager.h, http_server.cpp]
2026-02-19 feat(mock): add token-level metrics and crash tracking
    Align mock dispenser with firmware changes:
    - crashes: New counter for crash recovery scenarios
    Updates:
    - All scenarios now track requested_tokens when transactions start
    - Successful dispenses track dispensed_tokens on completion
    - Partial dispenses (jams, timeouts) track dispensed_tokens
    - Crash scenario (quantity=5) increments crash counter
    - Hardware error scenarios track requested_tokens only
    Aligns with commit c5c6e6c in firmware/dispenser.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
2026-02-19 fix(mock): simulate ESP restart after crash scenario
    The crash_after_first scenario (qty=5) left activeTx set indefinitely,
    causing /health to permanently report "dispensing". This did not match
    real firmware behavior where an ESP crash causes an MCU reset, losing
    all RAM state.
    After dispensing 1 token, the goroutine now waits 2 seconds (simulating
    restart time) then clears activeTx without adding to history. This means:
    - /health returns "idle" after ~2s (matching post-restart firmware)
    - GET /dispense/{txId} returns 404 (state lost on restart)
    - Terminal recovery service receives 404 → sets lastKnownState=not_found
    → manual reconciliation prompt shown to operator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
2026-02-25 fix(dispenser): stop motor at ISR level to prevent double-dispense
    Root cause: motor was stopped only on the next loop() iteration (up to
    10ms after the coin pulse fired). During that window the disc kept
    spinning due to mechanical inertia and could push a 2nd coin through
    the exit chute (~10% rate for quantity=1).
    Fix: arm a volatile `isr_stop_at` target before startMotor(). The
    coin-pulse ISR now writes MOTOR_PIN LOW the instant pulse_count reaches
    the target, reducing stop latency from ~10ms to ~microseconds. The main
    loop() still handles state transition to STATE_DONE as before.
    Also removes duplicate errorDecoder.begin() / attachInterrupt() /
    hopperControlInstance block that was calle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
    [dispense_manager.cpp, hopper_control.cpp, hopper_control.h, test_crash_recovery_metrics.cpp, test_dispense_manager_impl.cpp]
2026-09-20 docs(hardware): add enclosure drawings, coin funnel, fuse and buck converter docs
    - hardware/enclosure: parametric drawing scripts and generated drawings
    (cabinet front view with door slot, coin cup, wiring duct, articulated
    hasp detail; 1:1 flat patterns for the riveted aluminium coin funnel)
    - hardware/enclosure/einkaufsliste.md: shopping list for cabinet, hasp,
    wiring duct, fuse and small parts
    - document the Mini-360 buck converter (set to 5.0V, lock trimmer) and the
    inline 4A fuse F1 in hardware/README.md, the power diagram and CLAUDE.md
